Marco-Peter/Morgenmuffel/README.md

# Morgenmuffel
Ein nicht so muffiger Radiowecker
