Marco-Peter/Morgenmuffel/schema/Amplifier.kicad_sch

## KiCad design schema/Amplifier.kicad_sch (2022-03-19)

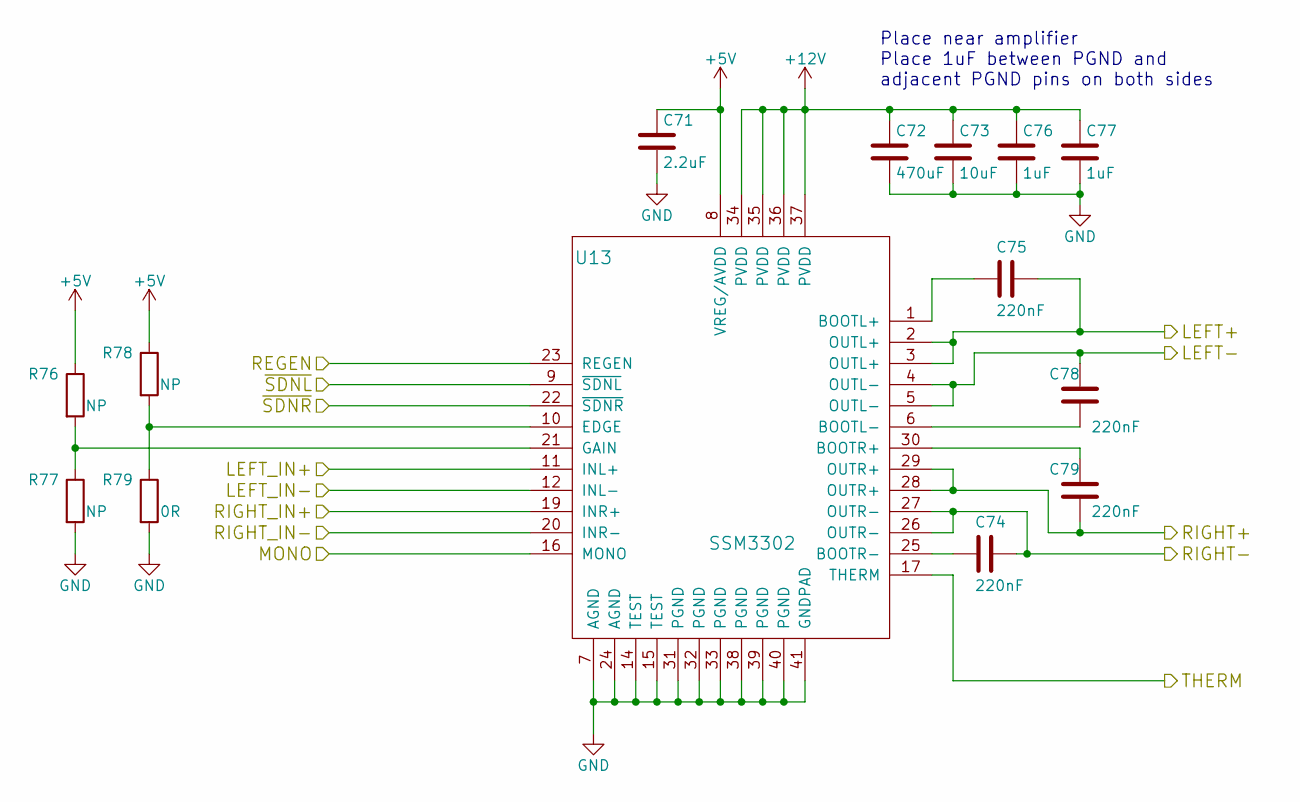
[picture p1: schematic Amplifier.kicad_sch]

Parts:
C71: 2.2uF; C_0603_HandSoldering
C72: 470uF; c_elec_10x10
C73: 10uF; C_1206_HandSoldering
C74, C75, C78, C79: 220nF; C_0603_HandSoldering
C76, C77: 1uF; C_0603_HandSoldering
R76, R77, R78: NP; R_0603_HandSoldering
R79: 0R; R_0603_HandSoldering
U13: SSM3302; QFN_40

Connections:
+5V: C71.1, R76.1, R78.1, U13.8 (VREG/AVDD)
+12V: C72.1, C73.1, C76.1, C77.1, U13.34 (PVDD), U13.35 (PVDD), U13.36 (PVDD), U13.37 (PVDD)
GND: C71.2, C72.2, C73.2, C76.2, C77.2, R77.2, R79.2, U13.7 (AGND), U13.14 (TEST), U13.15 (TEST), U13.24 (AGND), U13.31 (PGND), U13.32 (PGND), U13.33 (PGND), U13.38 (PGND), U13.39 (PGND), U13.40 (PGND), U13.41 (GNDPAD)
LEFT+: C75.1, U13.2 (OUTL+), U13.3 (OUTL+)
LEFT-: C78.1, U13.4 (OUTL-), U13.5 (OUTL-)
LEFT_IN+: U13.11 (INL+)
LEFT_IN-: U13.12 (INL-)
MONO: U13.16 (MONO)
unnamed: C74.2, U13.25 (BOOTR-)
unnamed: C75.2, U13.1 (BOOTL+)
unnamed: C78.2, U13.6 (BOOTL-)
unnamed: C79.1, U13.30 (BOOTR+)
unnamed: R76.2, R77.1, U13.21 (GAIN)
unnamed: R78.2, R79.1, U13.10 (EDGE)
REGEN: U13.23 (REGEN)
RIGHT+: C79.2, U13.28 (OUTR+), U13.29 (OUTR+)
RIGHT-: C74.1, U13.26 (OUTR-), U13.27 (OUTR-)
RIGHT_IN+: U13.19 (INR+)
RIGHT_IN-: U13.20 (INR-)
THERM: U13.17 (THERM)
~SDNL: U13.9 (~SDNL)
~SDNR: U13.22 (~SDNR)

Notes on the sheet:
Place near amplifier Place 1uF between PGND and adjacent PGND pins on both sides
