Marco-Peter/Morgenmuffel/schema/AudioOut.kicad_sch

## KiCad design schema/AudioOut.kicad_sch (2022-03-19)

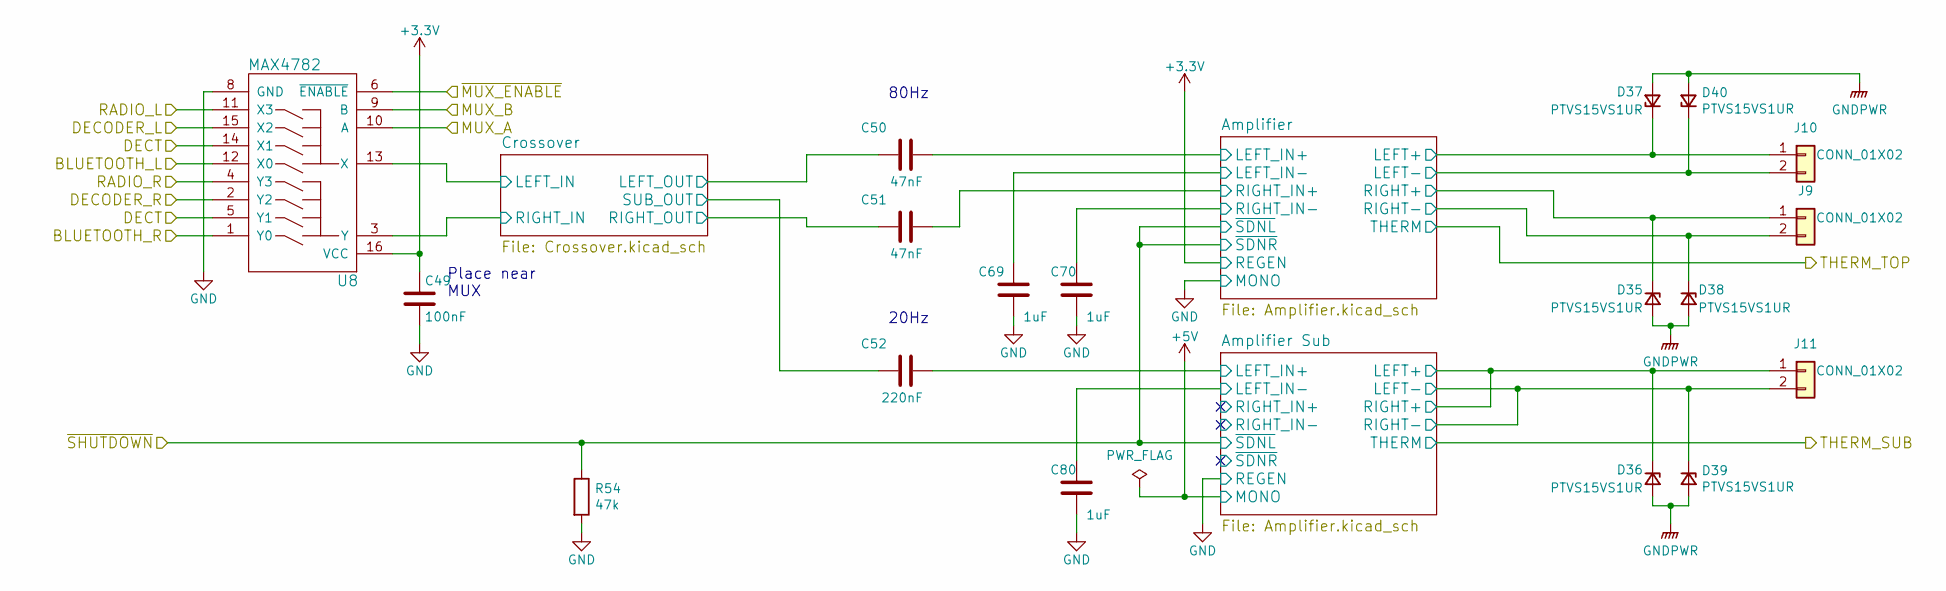
[picture p2: schematic AudioOut.kicad_sch]

Parts:
C49: 100nF; C_0603_HandSoldering
C50, C51: 47nF; C_0603_HandSoldering
C52: 220nF; C_0603_HandSoldering
C69, C70, C80: 1uF; C_0603_HandSoldering
D35, D36, D37, D38, D39, D40: PTVS15VS1UR; SOD-123
J9, J10, J11: CONN_01X02; PINHEAD1-2
R54: 47k; R_0603_HandSoldering
U8: MAX4782; TSSOP-16_4.4x5mm_Pitch0.65mm

Connections:
+3.3V: C49.1, U8.16 (VCC)
BLUETOOTH_L: U8.12 (X0)
BLUETOOTH_R: U8.1 (Y0)
DECODER_L: U8.15 (X2)
DECODER_R: U8.2 (Y2)
DECT: U8.5 (Y1), U8.14 (X1)
GND: C49.2, C69.2, C70.2, C80.2, R54.2, U8.8 (GND)
GNDPWR: D35.2 (A), D36.2 (A), D37.2 (A), D38.2 (A), D39.2 (A), D40.2 (A)
LEFT+: D36.1 (K), D37.1 (K), J10.1, J11.1
LEFT-: D39.1 (K), D40.1 (K), J10.2, J11.2
LEFT_IN: U8.13 (X)
LEFT_IN+: C50.2, C52.2
LEFT_IN-: C69.1, C80.1
LEFT_OUT: C50.1
MUX_A: U8.10 (A)
MUX_B: U8.9 (B)
RADIO_L: U8.11 (X3)
RADIO_R: U8.4 (Y3)
RIGHT+: D35.1 (K), J9.1
RIGHT-: D38.1 (K), J9.2
RIGHT_IN: U8.3 (Y)
RIGHT_IN+: C51.2
RIGHT_IN-: C70.1
RIGHT_OUT: C51.1
SUB_OUT: C52.1
~MUX_ENABLE: U8.6 (~ENABLE)
~SHUTDOWN: R54.1

Notes on the sheet:
80Hz
Place near MUX
20Hz
