Marco-Peter/Morgenmuffel/schema/BlueTooth.kicad_sch

## KiCad design schema/BlueTooth.kicad_sch (2022-03-19)

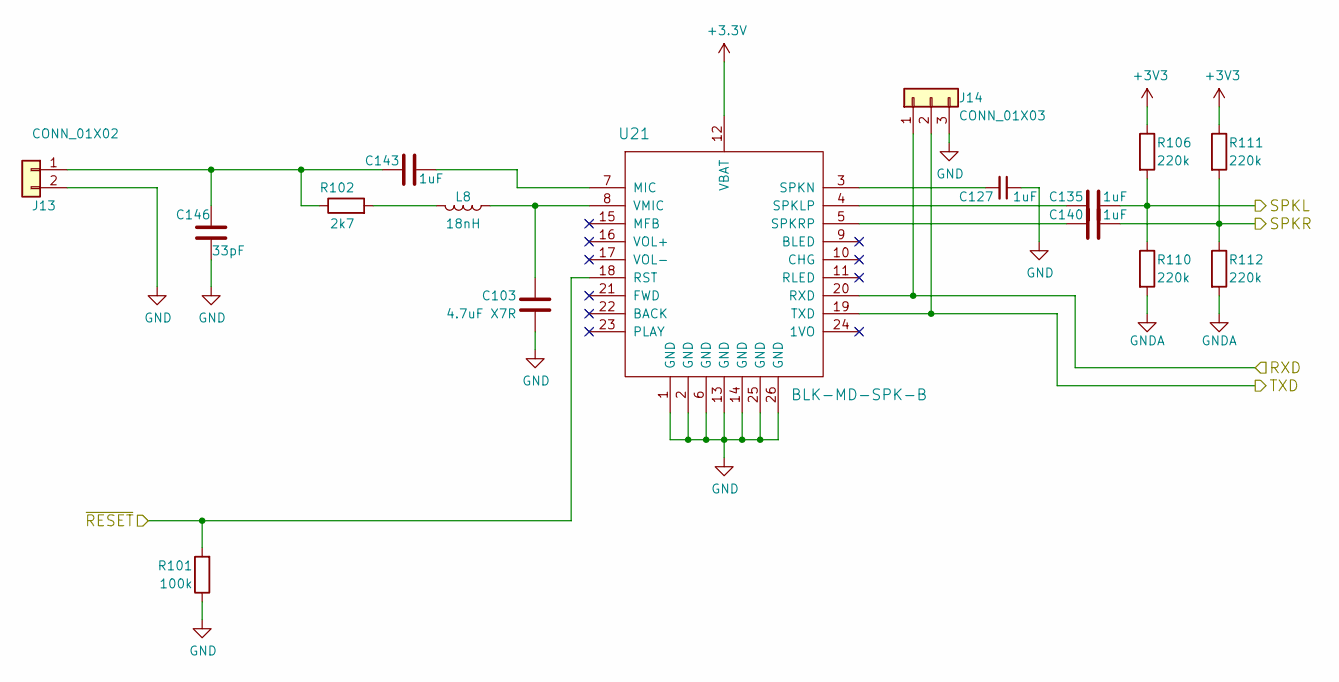
[picture p3: schematic BlueTooth.kicad_sch]

Parts:
C103: 4.7uF X7R; C_1206_HandSoldering
C127, C135, C140, C143: 1uF; C_0603_HandSoldering
C146: 33pF; C_0603_HandSoldering
J13: CONN_01X02; Pin_Header_Straight_1x02
J14: CONN_01X03; Pin_Header_Straight_1x03
L8: 18nH; R_0603_HandSoldering
R101: 100k; R_0603_HandSoldering
R102: 2k7; R_0603_HandSoldering
R106, R110, R111, R112: 220k; R_0603_HandSoldering
U21: BLK-MD-SPK-B

Connections:
+3.3V: U21.12 (VBAT)
+3V3: R106.1, R111.1
GND: C103.2, C127.1, C146.2, J13.2, J14.3, R101.1, U21.1 (GND), U21.2 (GND), U21.6 (GND), U21.13 (GND), U21.14 (GND), U21.25 (GND), U21.26 (GND)
GNDA: R110.2, R112.2
unnamed: C103.1, L8.1, U21.8 (VMIC)
unnamed: C127.2, U21.3 (SPKN)
unnamed: C135.2, U21.4 (SPKLP)
unnamed: C140.2, U21.5 (SPKRP)
unnamed: C143.1, U21.7 (MIC)
unnamed: C143.2, C146.1, J13.1, R102.1
unnamed: L8.2, R102.2
RXD: J14.1, U21.20 (RXD)
SPKL: C135.1, R106.2, R110.1
SPKR: C140.1, R111.2, R112.1
TXD: J14.2, U21.19 (TXD)
~RESET: R101.2, U21.18 (RST)
