Marco-Peter/Morgenmuffel/schema/Button.kicad_sch

## KiCad design schema/Button.kicad_sch (2022-03-19)

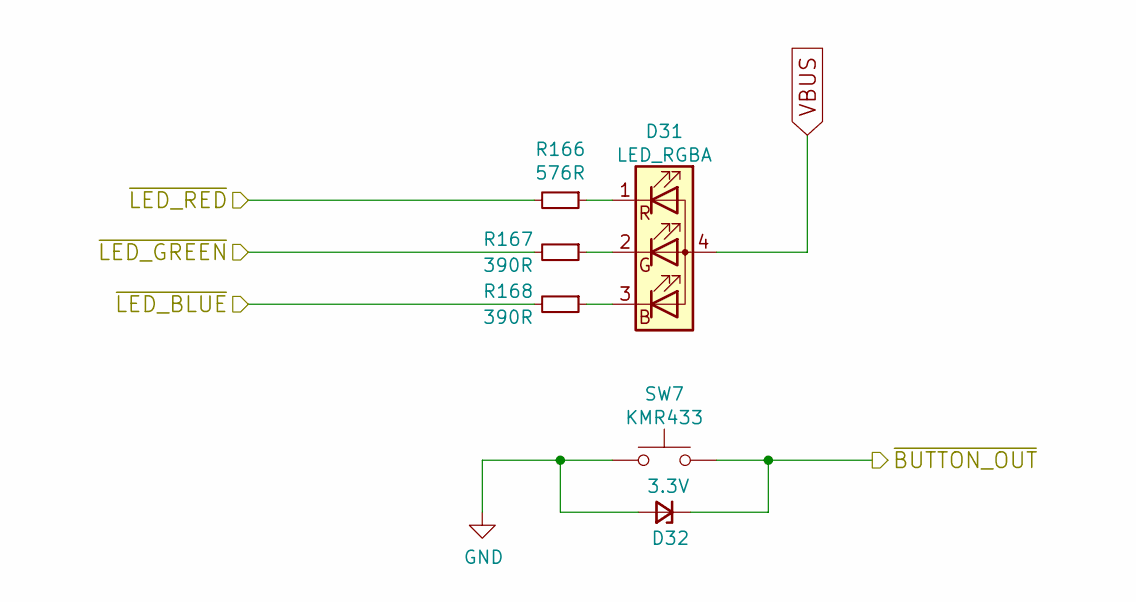
[picture p4: schematic Button.kicad_sch]

Parts:
D31: LED_RGBA; LED-PLCC4
D32: 3.3V; SOD-523
R166: 576R; R_0603_HandSoldering
R167, R168: 390R; R_0603_HandSoldering
SW7: KMR433; SW_SPST_KMR2

Connections:
GND: D32.2 (A), SW7.1
unnamed: D31.1 (RK), R166.1
unnamed: D31.2 (GK), R167.1
unnamed: D31.3 (BK), R168.1
VBUS: D31.4 (A)
~BUTTON_OUT: D32.1 (K), SW7.2
~LED_BLUE: R168.2
~LED_GREEN: R167.2
~LED_RED: R166.2
