Marco-Peter/Morgenmuffel/schema/CPU.kicad_sch

## KiCad design schema/CPU.kicad_sch (2022-03-19)

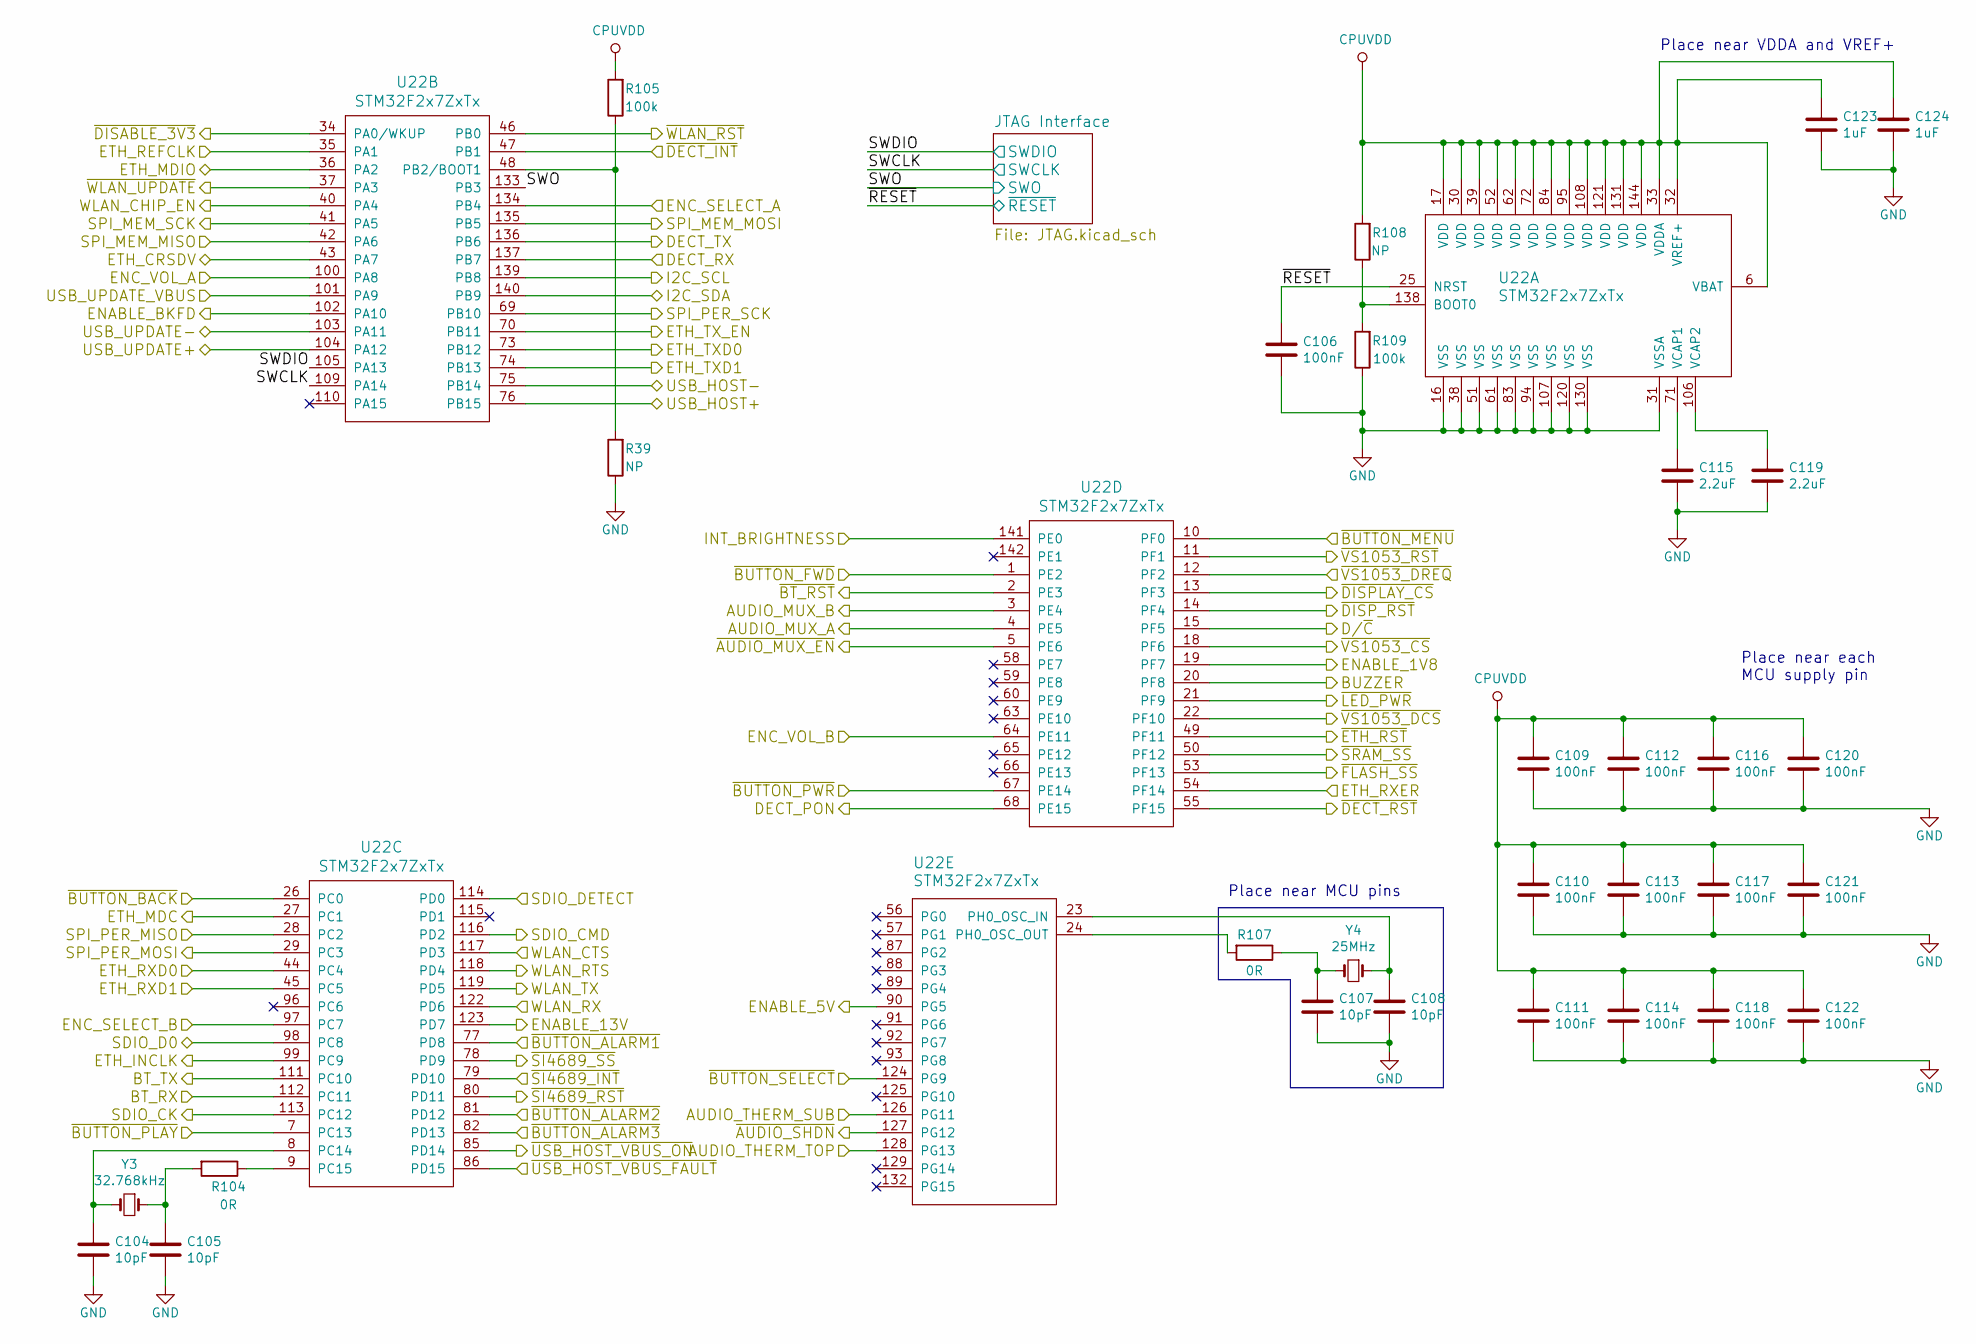
[picture p5: schematic CPU.kicad_sch]

Parts:
C104, C105, C107, C108: 10pF; C_0603_HandSoldering
C106, C109, C110, C111, C112, C113, C114, C116, C117, C118, C120, C121, C122: 100nF; C_0603_HandSoldering
C115, C119: 2.2uF; C_0603_HandSoldering
C123, C124: 1uF; C_0603_HandSoldering
R39, R108: NP; R_0603_HandSoldering
R104, R107: 0R; R_0603_HandSoldering
R105, R109: 100k; R_0603_HandSoldering
U22: STM32F2x7ZxTx; LQFP-144_20x20mm_Pitch0.5mm
Y3: 32.768kHz; R_0805_HandSoldering
Y4: 25MHz; Crystal_SMD_5032_4Pads

Connections:
AUDIO_MUX_A: U22.4 (PE5)
AUDIO_MUX_B: U22.3 (PE4)
AUDIO_THERM_SUB: U22.126 (PG11)
AUDIO_THERM_TOP: U22.128 (PG13)
BT_RX: U22.112 (PC11)
BT_TX: U22.111 (PC10)
BUZZER: U22.20 (PF8)
CPUVDD: C109.1, C110.1, C111.1, C112.1, C113.1, C114.1, C116.1, C117.1, C118.1, C120.1, C121.1, C122.1, C123.1, C124.1, R105.2, R108.2, U22.6 (VBAT), U22.17 (VDD), U22.30 (VDD), U22.32 (VREF+), U22.33 (VDDA), U22.39 (VDD), U22.52 (VDD), U22.62 (VDD), U22.72 (VDD), U22.84 (VDD), U22.95 (VDD), U22.108 (VDD), U22.121 (VDD), U22.131 (VDD), U22.144 (VDD)
D/~C: U22.15 (PF5)
DECT_PON: U22.68 (PE15)
DECT_RX: U22.137 (PB7)
DECT_TX: U22.136 (PB6)
ENABLE_1V8: U22.19 (PF7)
ENABLE_5V: U22.90 (PG5)
ENABLE_13V: U22.123 (PD7)
ENABLE_BKFD: U22.102 (PA10)
ENC_SELECT_A: U22.134 (PB4)
ENC_SELECT_B: U22.97 (PC7)
ENC_VOL_A: U22.100 (PA8)
ENC_VOL_B: U22.64 (PE11)
ETH_CRSDV: U22.43 (PA7)
ETH_INCLK: U22.99 (PC9)
ETH_MDC: U22.27 (PC1)
ETH_MDIO: U22.36 (PA2)
ETH_REFCLK: U22.35 (PA1)
ETH_RXD0: U22.44 (PC4)
ETH_RXD1: U22.45 (PC5)
ETH_RXER: U22.54 (PF14)
ETH_TXD0: U22.73 (PB12)
ETH_TXD1: U22.74 (PB13)
ETH_TX_EN: U22.70 (PB11)
GND: C104.2, C105.2, C106.2, C107.2, C108.2, C109.2, C110.2, C111.2, C112.2, C113.2, C114.2, C115.2, C116.2, C117.2, C118.2, C119.2, C120.2, C121.2, C122.2, C123.2, C124.2, R39.1, R109.1, U22.16 (VSS), U22.31 (VSSA), U22.38 (VSS), U22.51 (VSS), U22.61 (VSS), U22.83 (VSS), U22.94 (VSS), U22.107 (VSS), U22.120 (VSS), U22.130 (VSS)
I2C_SCL: U22.139 (PB8)
I2C_SDA: U22.140 (PB9)
INT_BRIGHTNESS: U22.141 (PE0)
unnamed: C104.1, U22.8 (PC14), Y3.2
unnamed: C105.1, R104.2, Y3.1
unnamed: C107.1, R107.1, Y4.2
unnamed: C108.1, U22.23 (PH0_OSC_IN), Y4.1
unnamed: C115.1, U22.71 (VCAP1)
unnamed: C119.1, U22.106 (VCAP2)
unnamed: R104.1, U22.9 (PC15)
unnamed: R39.2, R105.1, U22.48 (PB2/BOOT1)
unnamed: R107.2, U22.24 (PH0_OSC_OUT)
unnamed: R108.1, R109.2, U22.138 (BOOT0)
SDIO_CK: U22.113 (PC12)
SDIO_CMD: U22.116 (PD2)
SDIO_D0: U22.98 (PC8)
SDIO_DETECT: U22.114 (PD0)
SPI_MEM_MISO: U22.42 (PA6)
SPI_MEM_MOSI: U22.135 (PB5)
SPI_MEM_SCK: U22.41 (PA5)
SPI_PER_MISO: U22.28 (PC2)
SPI_PER_MOSI: U22.29 (PC3)
SPI_PER_SCK: U22.69 (PB10)
SWCLK: U22.109 (PA14)
SWDIO: U22.105 (PA13)
SWO: U22.133 (PB3)
USB_HOST+: U22.76 (PB15)
USB_HOST-: U22.75 (PB14)
USB_UPDATE+: U22.104 (PA12)
USB_UPDATE-: U22.103 (PA11)
USB_UPDATE_VBUS: U22.101 (PA9)
WLAN_CHIP_EN: U22.40 (PA4)
WLAN_CTS: U22.117 (PD3)
WLAN_RTS: U22.118 (PD4)
WLAN_RX: U22.122 (PD6)
WLAN_TX: U22.119 (PD5)
~AUDIO_MUX_EN: U22.5 (PE6)
~AUDIO_SHDN: U22.127 (PG12)
~BT_RST: U22.2 (PE3)
~BUTTON_ALARM1: U22.77 (PD8)
~BUTTON_ALARM2: U22.81 (PD12)
~BUTTON_ALARM3: U22.82 (PD13)
~BUTTON_BACK: U22.26 (PC0)
~BUTTON_FWD: U22.1 (PE2)
~BUTTON_MENU: U22.10 (PF0)
~BUTTON_PLAY: U22.7 (PC13)
~BUTTON_PWR: U22.67 (PE14)
~BUTTON_SELECT: U22.124 (PG9)
~DECT_INT: U22.47 (PB1)
~DECT_RST: U22.55 (PF15)
~DISABLE_3V3: U22.34 (PA0/WKUP)
~DISPLAY_CS: U22.13 (PF3)
~DISP_RST: U22.14 (PF4)
~ETH_RST: U22.49 (PF11)
~FLASH_SS: U22.53 (PF13)
~LED_PWR: U22.21 (PF9)
~RESET: C106.1, U22.25 (NRST)
~SI4689_INT: U22.79 (PD10)
~SI4689_RST: U22.80 (PD11)
~SI4689_SS: U22.78 (PD9)
~SRAM_SS: U22.50 (PF12)
~USB_HOST_VBUS_FAULT: U22.86 (PD15)
~USB_HOST_VBUS_ON: U22.85 (PD14)
~VS1053_CS: U22.18 (PF6)
~VS1053_DCS: U22.22 (PF10)
~VS1053_DREQ: U22.12 (PF2)
~VS1053_RST: U22.11 (PF1)
~WLAN_RST: U22.46 (PB0)
~WLAN_UPDATE: U22.37 (PA3)

Notes on the sheet:
Place near MCU pins
Place near VDDA and VREF+
Place near each MCU supply pin
