Marco-Peter/Morgenmuffel/schema/Crossover.kicad_sch

## KiCad design schema/Crossover.kicad_sch (2022-03-19)

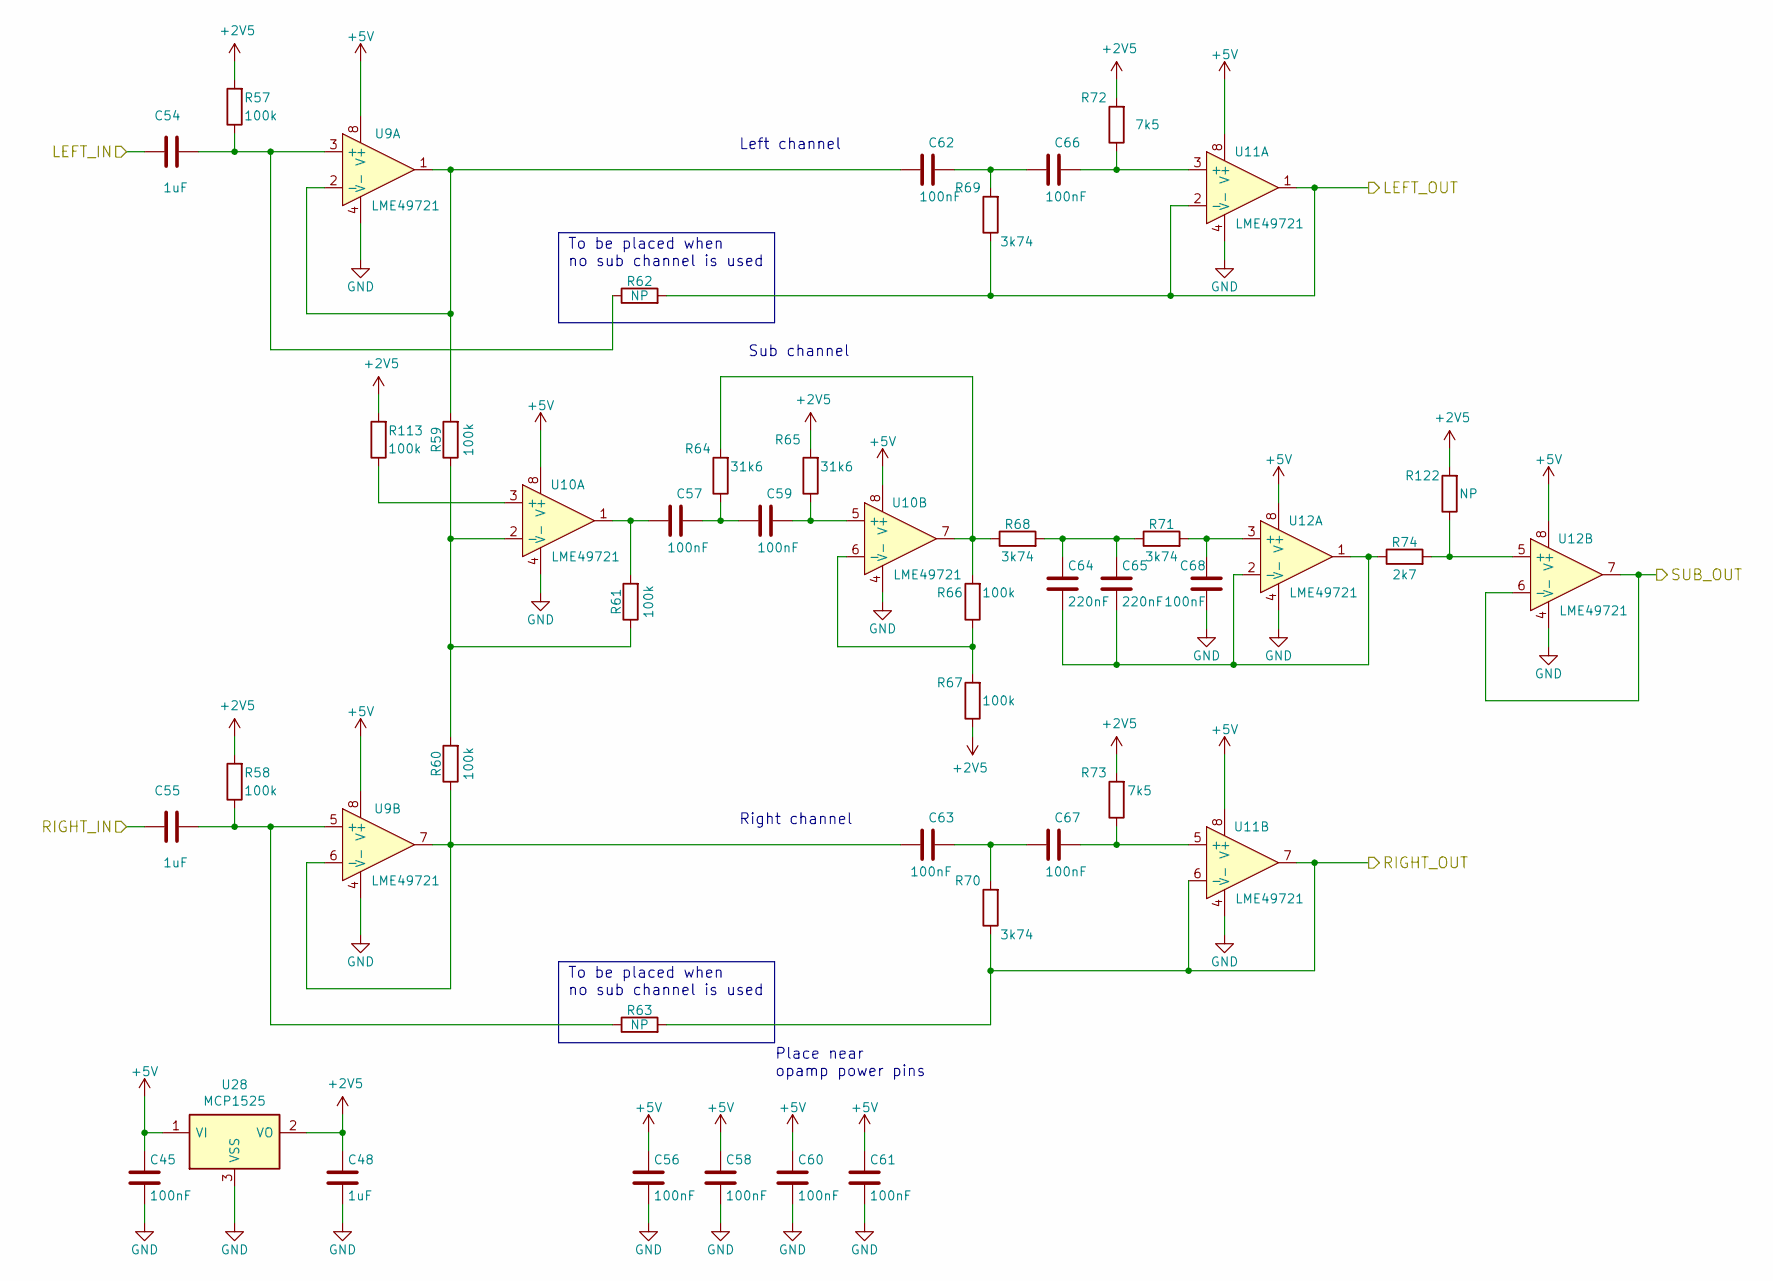
[picture p6: schematic Crossover.kicad_sch]

Parts:
C45, C56, C57, C58, C59, C60, C61, C62, C63, C66, C67, C68: 100nF; C_0603_HandSoldering
C48, C54, C55: 1uF; C_0603_HandSoldering
C64, C65: 220nF; C_0603_HandSoldering
R57, R58, R59, R60, R61, R66, R67, R113: 100k; R_0603_HandSoldering
R62, R63, R122: NP; R_0603_HandSoldering
R64, R65: 31k6; R_0603_HandSoldering
R68, R69, R70, R71: 3k74; R_0603_HandSoldering
R72, R73: 7k5; R_0603_HandSoldering
R74: 2k7; R_0603_HandSoldering
U9, U10, U11, U12: LME49721; SOIC-8_3.9x4.9mm_Pitch1.27mm
U28: MCP1525; SOT-23_Handsoldering

Connections:
+2V5: C48.1, R57.2, R58.2, R65.2, R67.1, R72.2, R73.2, R113.2, R122.2, U28.2 (VO)
+5V: C45.1, C56.1, C58.1, C60.1, C61.1, U9.8 (V+), U10.8 (V+), U11.8 (V+), U12.8 (V+), U28.1 (VI)
GND: C45.2, C48.2, C56.2, C58.2, C60.2, C61.2, C68.2, U9.4 (V-), U10.4 (V-), U11.4 (V-), U12.4 (V-), U28.3 (VSS)
LEFT_IN: C54.2
LEFT_OUT: R62.2, R69.1, U11.1, U11.2 (-)
unnamed: C54.1, R57.1, R62.1, U9.3 (+)
unnamed: C55.1, R58.1, R63.1, U9.5 (+)
unnamed: C57.1, C59.2, R64.1
unnamed: C57.2, R61.2, U10.1
unnamed: C59.1, R65.1, U10.5 (+)
unnamed: C62.1, C66.2, R69.2
unnamed: C62.2, R59.2, U9.1, U9.2 (-)
unnamed: C63.1, C67.2, R70.2
unnamed: C63.2, R60.1, U9.6 (-), U9.7
unnamed: C64.1, C65.1, R68.2, R71.1
unnamed: C64.2, C65.2, R74.1, U12.1, U12.2 (-)
unnamed: C66.1, R72.1, U11.3 (+)
unnamed: C67.1, R73.1, U11.5 (+)
unnamed: C68.1, R71.2, U12.3 (+)
unnamed: R59.1, R60.2, R61.1, U10.2 (-)
unnamed: R64.2, R66.2, R68.1, U10.7
unnamed: R66.1, R67.2, U10.6 (-)
unnamed: R113.1, U10.3 (+)
unnamed: R74.2, R122.1, U12.5 (+)
RIGHT_IN: C55.2
RIGHT_OUT: R63.2, R70.1, U11.6 (-), U11.7
SUB_OUT: U12.6 (-), U12.7

Notes on the sheet:
Place near opamp power pins
To be placed when no sub channel is used
Sub channel
Right channel
Left channel
