Marco-Peter/Morgenmuffel/schema/DECT.kicad_sch

## KiCad design schema/DECT.kicad_sch (2022-03-19)

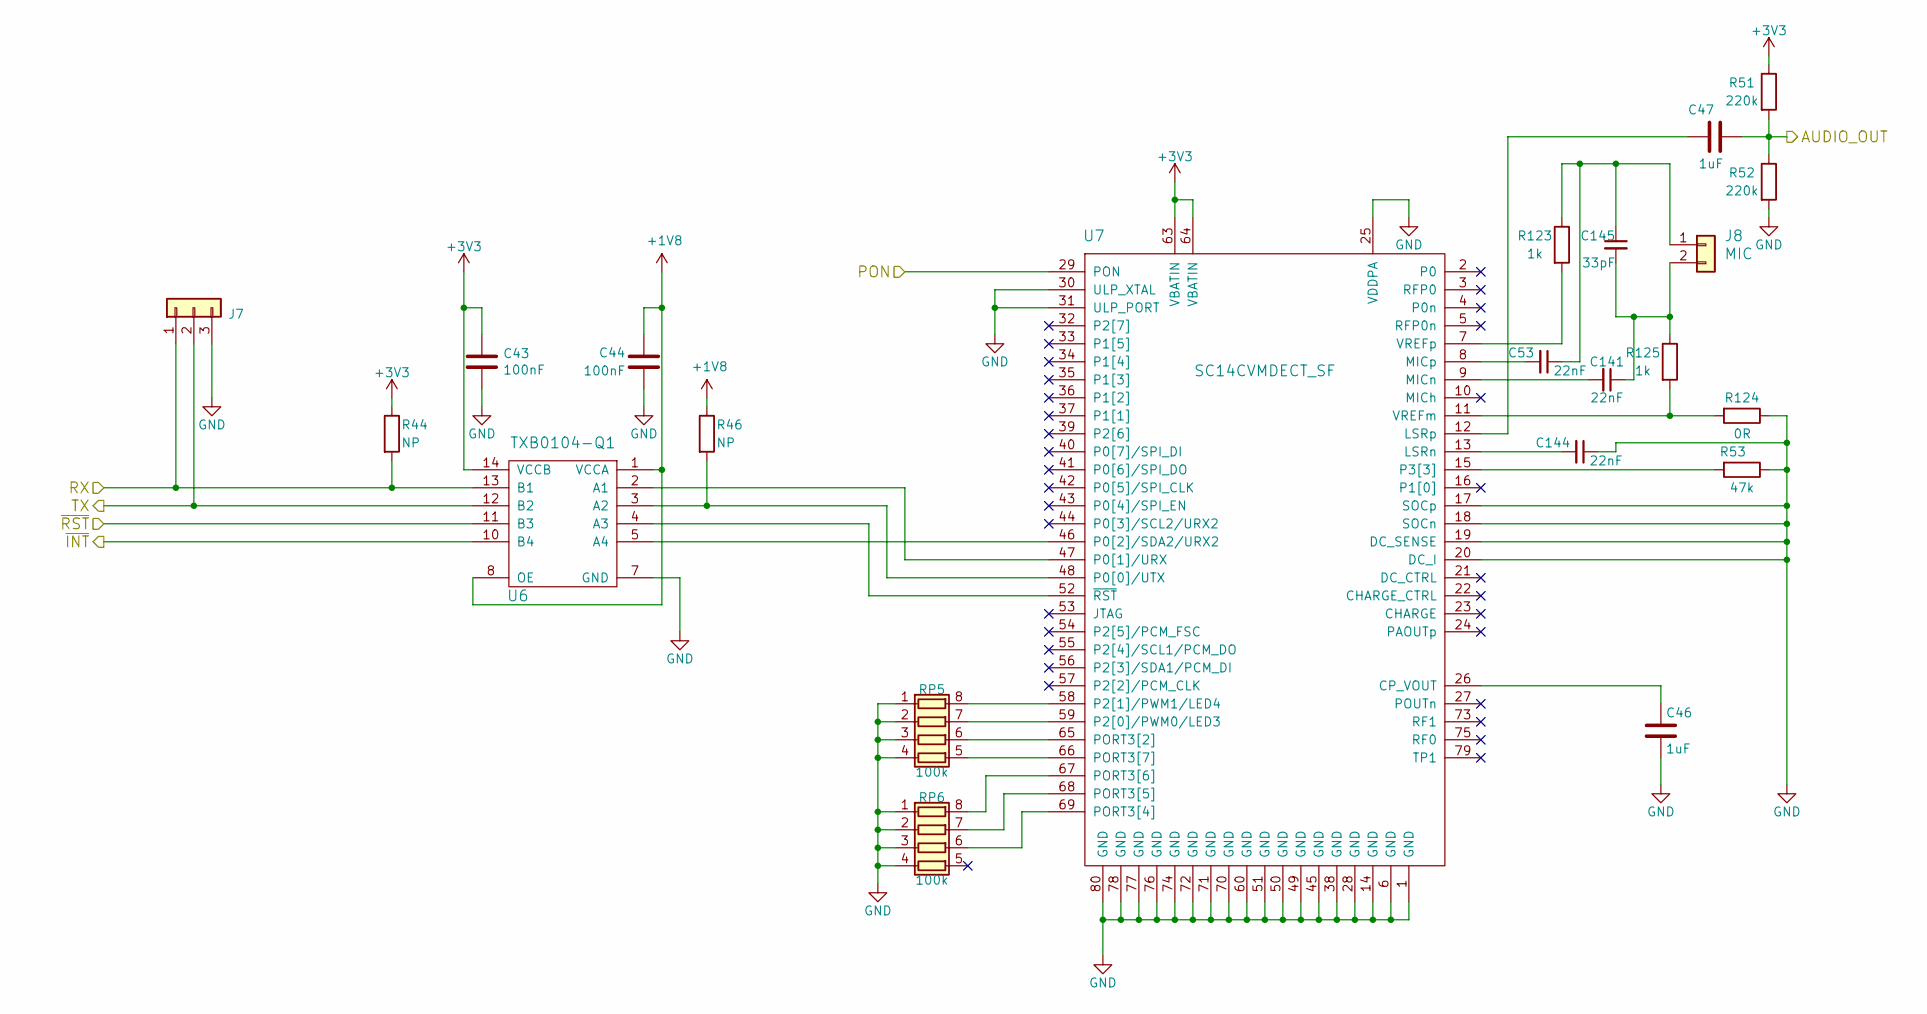
[picture p7: schematic DECT.kicad_sch]

Parts:
C43, C44: 100nF; C_0603_HandSoldering
C46, C47: 1uF; C_0603_HandSoldering
C53, C141, C144: 22nF; C_0603_HandSoldering
C145: 33pF; C_0603_HandSoldering
J7: CONN_01X03; Pin_Header_Straight_1x03
J8: MIC; Pin_Header_Straight_1x02
R44, R46: NP; R_0603_HandSoldering
R51, R52: 220k; R_0603_HandSoldering
R53: 47k; R_0603_HandSoldering
R123, R125: 1k; R_0603_HandSoldering
R124: 0R; R_0603_HandSoldering
RP5, RP6: 100k; R_Array_Convex_4x0603
U6: TXB0104-Q1; TSSOP-14_4.4x5mm_Pitch0.65mm
U7: SC14CVMDECT_SF

Connections:
+1V8: C44.1, R46.1, U6.1 (VCCA), U6.8 (OE)
+3V3: C43.1, R44.1, R51.1, U6.14 (VCCB), U7.63 (VBATIN), U7.64 (VBATIN)
AUDIO_OUT: C47.2, R51.2, R52.1
GND: C43.2, C44.2, C46.2, C144.1, J7.3, R52.2, R53.1, R124.1, RP5.1 (R1.1), RP5.2 (R2.1), RP5.3 (R3.1), RP5.4 (R4.1), RP6.1 (R1.1), RP6.2 (R2.1), RP6.3 (R3.1), RP6.4 (R4.1), U6.7 (GND), U7.1 (GND), U7.6 (GND), U7.14 (GND), U7.17 (SOCp), U7.18 (SOCn), U7.19 (DC_SENSE), U7.20 (DC_I), U7.25 (VDDPA), U7.28 (GND), U7.30 (ULP_XTAL), U7.31 (ULP_PORT), U7.38 (GND), U7.45 (GND), U7.49 (GND), U7.50 (GND), U7.51 (GND), U7.60 (GND), U7.70 (GND), U7.71 (GND), U7.72 (GND), U7.74 (GND), U7.76 (GND), U7.77 (GND), U7.78 (GND), U7.80 (GND)
unnamed: C46.1, U7.26 (CP_VOUT)
unnamed: C47.1, U7.12 (LSRp)
unnamed: C53.2, U7.8 (MICp)
unnamed: C141.1, C145.2, J8.2, R125.1
unnamed: C141.2, U7.9 (MICn)
unnamed: C144.2, U7.13 (LSRn)
unnamed: C53.1, C145.1, J8.1, R123.1
unnamed: R46.2, U6.3 (A2), U7.48 (P0[0]/UTX)
unnamed: R53.2, U7.15 (P3[3])
unnamed: R123.2, U7.7 (VREFp)
unnamed: R124.2, R125.2, U7.11 (VREFm)
unnamed: RP5.5 (R4.2), U7.66 (PORT3[7])
unnamed: RP5.6 (R3.2), U7.65 (PORT3[2])
unnamed: RP5.7 (R2.2), U7.59 (P2[0]/PWM0/LED3)
unnamed: RP5.8 (R1.2), U7.58 (P2[1]/PWM1/LED4)
unnamed: RP6.6 (R3.2), U7.69 (PORT3[4])
unnamed: RP6.7 (R2.2), U7.68 (PORT3[5])
unnamed: RP6.8 (R1.2), U7.67 (PORT3[6])
unnamed: U6.2 (A1), U7.47 (P0[1]/URX)
unnamed: U6.4 (A3), U7.52 (~RST)
unnamed: U6.5 (A4), U7.46 (P0[2]/SDA2/URX2)
PON: U7.29 (PON)
RX: J7.1, R44.2, U6.13 (B1)
TX: J7.2, U6.12 (B2)
~INT: U6.10 (B4)
~RST: U6.11 (B3)
