Marco-Peter/Morgenmuffel/schema/Display.kicad_sch

## KiCad design schema/Display.kicad_sch (2022-03-19)

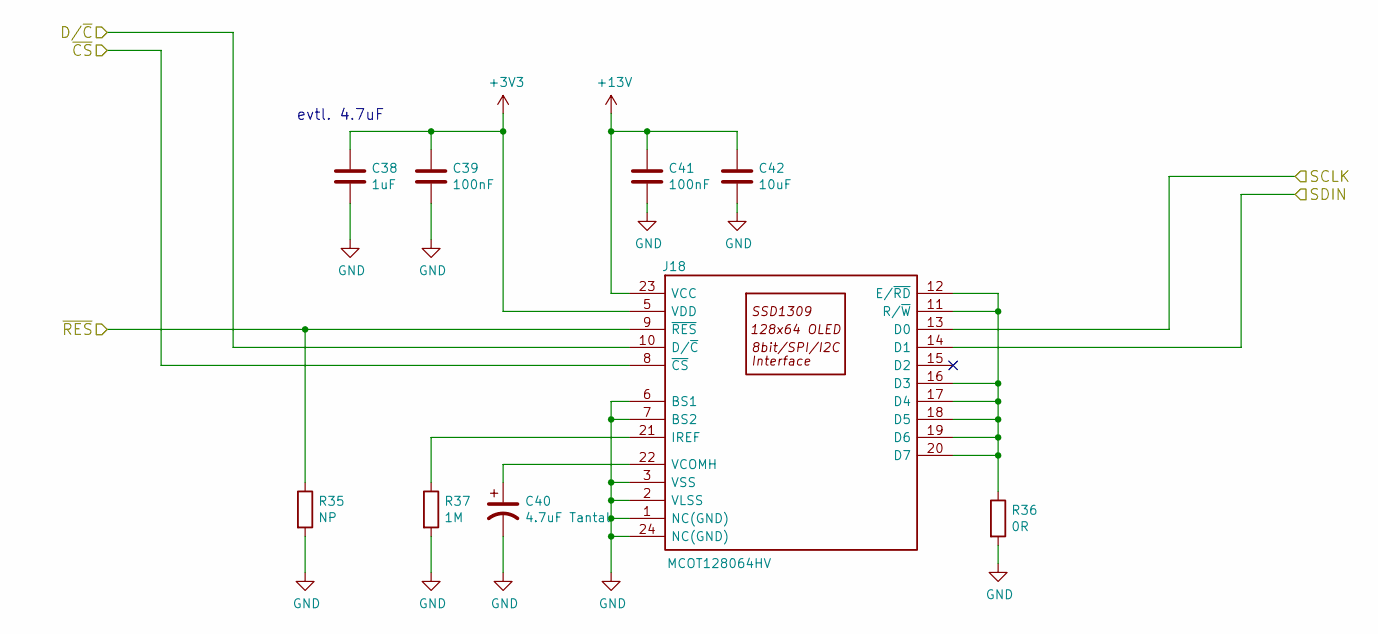
[picture p8: schematic Display.kicad_sch]

Parts:
C38: 1uF; C_0603_HandSoldering
C39, C41: 100nF; C_0603_HandSoldering
C40: 4.7uF Tantal; C_1206
C42: 10uF; C_1206_HandSoldering
J18: MCOT128064HV; FPC_24
R35: NP; R_0603_HandSoldering
R36: 0R; R_0603_HandSoldering
R37: 1M; R_0603_HandSoldering

Connections:
+3V3: C38.1, C39.1, J18.5 (VDD)
+13V: C41.1, C42.1, J18.23 (VCC)
D/~C: J18.10 (D/~C)
GND: C38.2, C39.2, C40.2, C41.2, C42.2, J18.1 (NC(GND)), J18.2 (VLSS), J18.3 (VSS), J18.6 (BS1), J18.7 (BS2), J18.24 (NC(GND)), R35.2, R36.2, R37.2
unnamed: C40.1, J18.22 (VCOMH)
unnamed: J18.11 (R/~W), J18.12 (E/~RD), J18.16 (D3), J18.17 (D4), J18.18 (D5), J18.19 (D6), J18.20 (D7), R36.1
unnamed: J18.21 (IREF), R37.1
SCLK: J18.13 (D0)
SDIN: J18.14 (D1)
~CS: J18.8 (~CS)
~RES: J18.9 (~RES), R35.1

Notes on the sheet:
evtl. 4.7uF
