Marco-Peter/Morgenmuffel/schema/Encoder.kicad_sch

## KiCad design schema/Encoder.kicad_sch (2022-03-19)

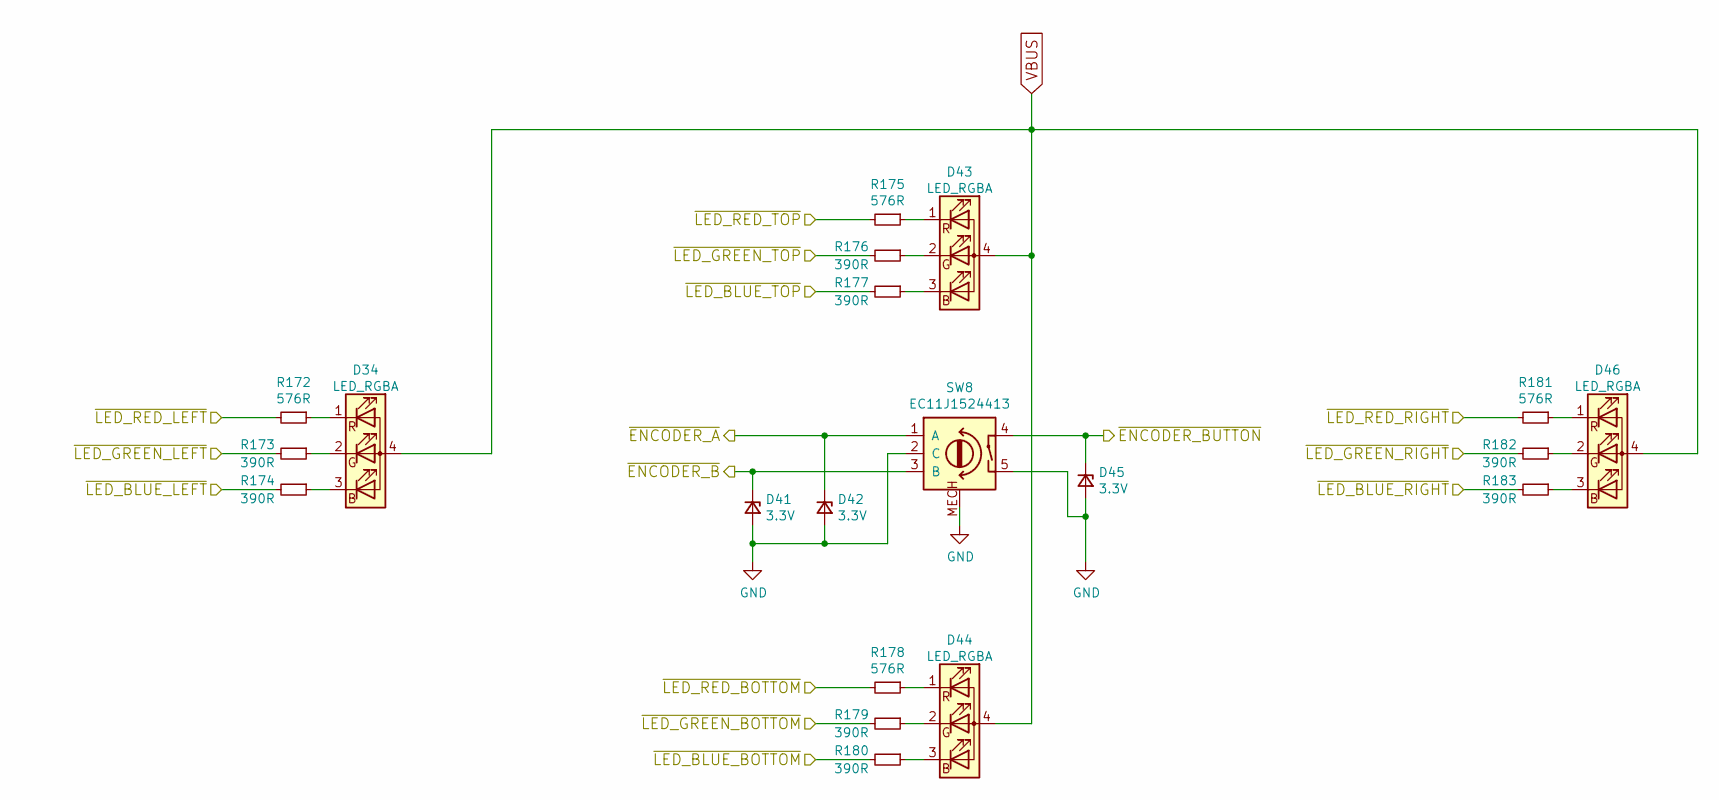
[picture p9: schematic Encoder.kicad_sch]

Parts:
D34, D43, D44, D46: LED_RGBA; LED-PLCC4
D41, D42, D45: 3.3V; SOD-523
R172, R175, R178, R181: 576R; R_0603_HandSoldering
R173, R174, R176, R177, R179, R180, R182, R183: 390R; R_0603_HandSoldering
SW8: EC11J1524413; Encoder_Alps_EC11J

Connections:
GND: D41.2 (A), D42.2 (A), D45.2 (A), SW8.2 (C), SW8.5, SW8.MECH
unnamed: D34.1 (RK), R172.1
unnamed: D34.2 (GK), R173.1
unnamed: D34.3 (BK), R174.1
unnamed: D43.1 (RK), R175.1
unnamed: D43.2 (GK), R176.1
unnamed: D43.3 (BK), R177.1
unnamed: D44.1 (RK), R178.1
unnamed: D44.2 (GK), R179.1
unnamed: D44.3 (BK), R180.1
unnamed: D46.1 (RK), R181.1
unnamed: D46.2 (GK), R182.1
unnamed: D46.3 (BK), R183.1
VBUS: D34.4 (A), D43.4 (A), D44.4 (A), D46.4 (A)
~ENCODER_A: D42.1 (K), SW8.1 (A)
~ENCODER_BUTTON: D45.1 (K), SW8.4
~ENCODER_B: D41.1 (K), SW8.3 (B)
~LED_BLUE_BOTTOM: R180.2
~LED_BLUE_LEFT: R174.2
~LED_BLUE_RIGHT: R183.2
~LED_BLUE_TOP: R177.2
~LED_GREEN_BOTTOM: R179.2
~LED_GREEN_LEFT: R173.2
~LED_GREEN_RIGHT: R182.2
~LED_GREEN_TOP: R176.2
~LED_RED_BOTTOM: R178.2
~LED_RED_LEFT: R172.2
~LED_RED_RIGHT: R181.2
~LED_RED_TOP: R175.2
