Marco-Peter/Morgenmuffel/schema/Ethernet.kicad_sch

## KiCad design schema/Ethernet.kicad_sch (2022-03-19)

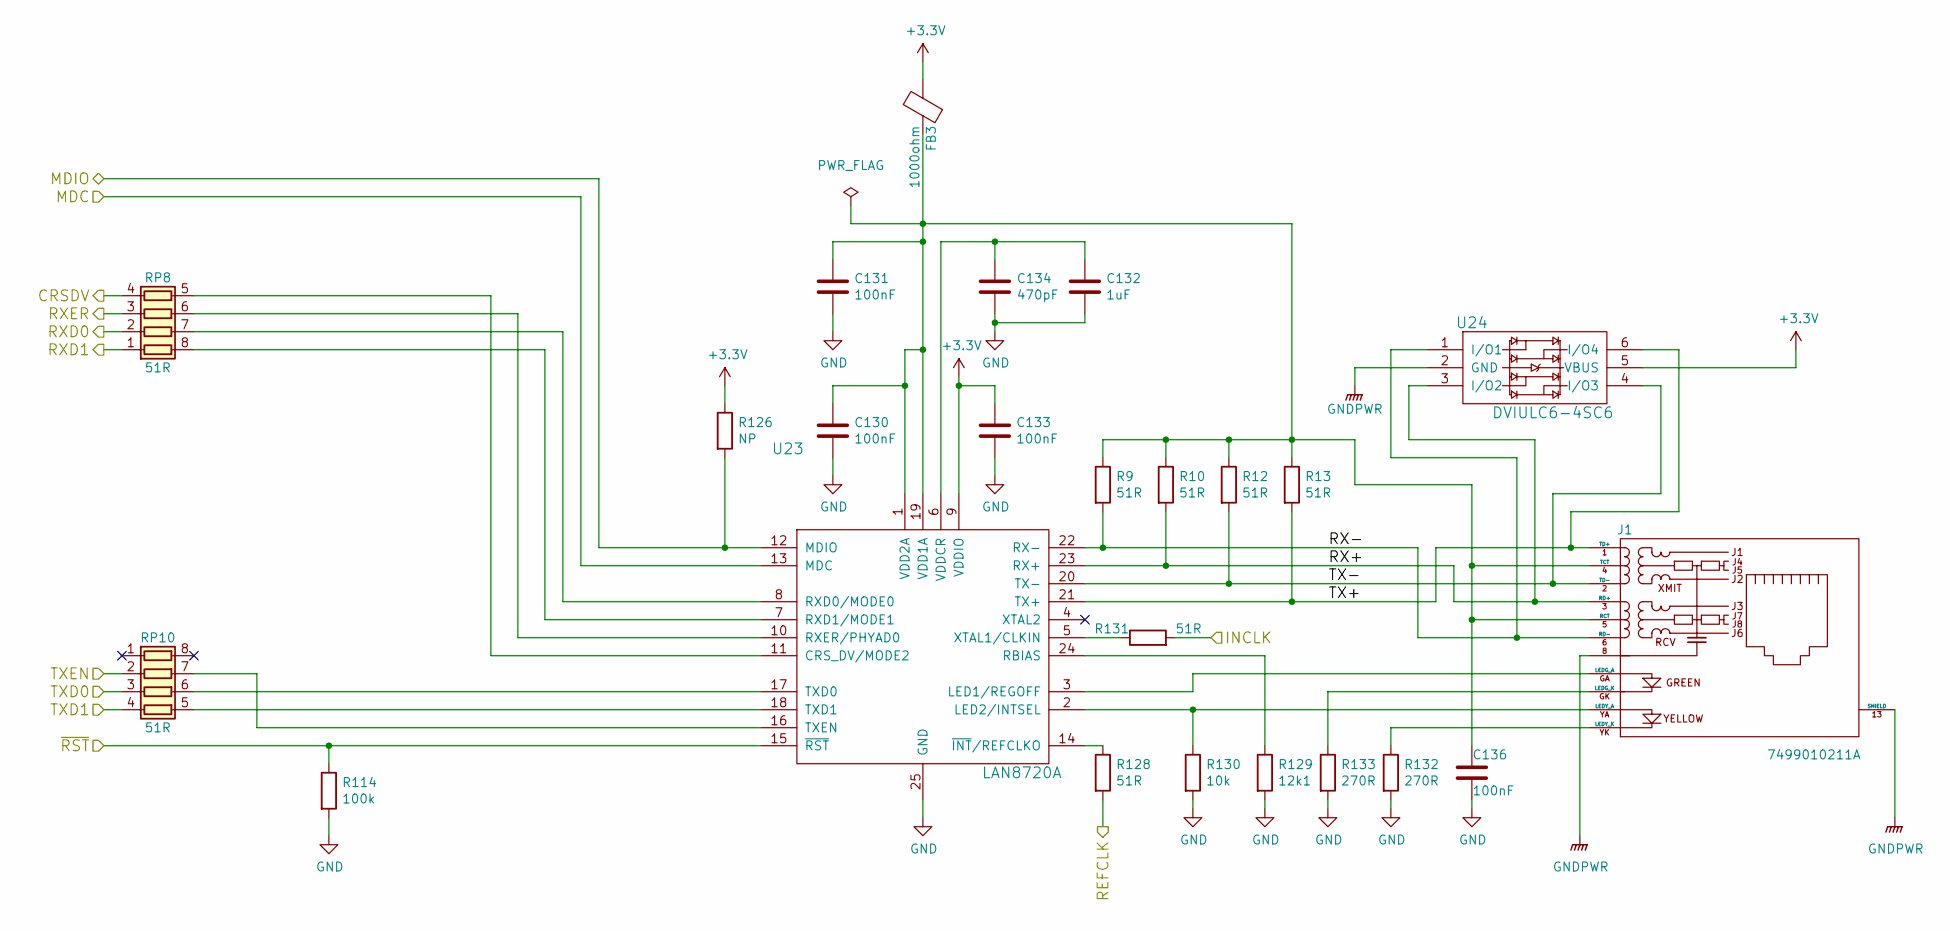
[picture p10: schematic Ethernet.kicad_sch]

Parts:
C130, C131, C133, C136: 100nF; C_0603_HandSoldering
C132: 1uF; C_0603_HandSoldering
C134: 470pF; C_0603_HandSoldering
FB3: 1000ohm; R_0603_HandSoldering
J1: 7499010211A
R9, R10, R12, R13, R128, R131: 51R; R_0603_HandSoldering
R114: 100k; R_0603_HandSoldering
R126: NP; R_0603_HandSoldering
R129: 12k1; R_0603_HandSoldering
R130: 10k; R_0603_HandSoldering
R132, R133: 270R; R_0603_HandSoldering
RP8, RP10: 51R; R_Array_Concave_4x0402
U23: LAN8720A; QFN_24
U24: DVIULC6-4SC6; SOT-23-6_Handsoldering; Part Number DVIULC6-4SC6

Connections:
+3.3V: C133.1, FB3.2, R126.1, U23.9 (VDDIO), U24.5 (VBUS)
CRSDV: RP8.4 (R4.1)
GND: C130.2, C131.2, C132.2, C133.2, C134.2, C136.2, R114.2, R129.2, R130.2, R132.2, R133.2, U23.25 (GND)
GNDPWR: J1.8, J1.13 (SHIELD), U24.2 (GND)
INCLK: R131.2
MDC: U23.13 (MDC)
MDIO: R126.2, U23.12 (MDIO)
unnamed: C130.1, C131.1, C136.1, FB3.1, J1.4 (TCT), J1.5 (RCT), R9.1, R10.1, R12.1, R13.1, U23.1 (VDD2A), U23.19 (VDD1A)
unnamed: C132.1, C134.1, U23.6 (VDDCR)
unnamed: J1.GA (LEDG_A), U23.3 (LED1/REGOFF)
unnamed: J1.GK (LEDG_K), R133.1
unnamed: J1.YA (LEDY_A), R130.1, U23.2 (LED2/INTSEL)
unnamed: J1.YK (LEDY_K), R132.1
unnamed: R128.1, U23.14 (~INT/REFCLKO)
unnamed: R129.1, U23.24 (RBIAS)
unnamed: R131.1, U23.5 (XTAL1/CLKIN)
unnamed: RP8.5 (R4.2), U23.11 (CRS_DV/MODE2)
unnamed: RP8.6 (R3.2), U23.10 (RXER/PHYAD0)
unnamed: RP8.7 (R2.2), U23.8 (RXD0/MODE0)
unnamed: RP8.8 (R1.2), U23.7 (RXD1/MODE1)
unnamed: RP10.5 (R4.2), U23.18 (TXD1)
unnamed: RP10.6 (R3.2), U23.17 (TXD0)
unnamed: RP10.7 (R2.2), U23.16 (TXEN)
REFCLK: R128.2
RX+: J1.3 (RD+), R10.2, U23.23 (RX+), U24.3 (I/O2)
RX-: J1.6 (RD-), R9.2, U23.22 (RX-), U24.1 (I/O1)
RXD0: RP8.2 (R2.1)
RXD1: RP8.1 (R1.1)
RXER: RP8.3 (R3.1)
TX+: J1.1 (TD+), R13.2, U23.21 (TX+), U24.6 (I/O4)
TX-: J1.2 (TD-), R12.2, U23.20 (TX-), U24.4 (I/O3)
TXD0: RP10.3 (R3.1)
TXD1: RP10.4 (R4.1)
TXEN: RP10.2 (R2.1)
~RST: R114.1, U23.15 (~RST)
