Marco-Peter/Morgenmuffel/schema/JTAG.kicad_sch

## KiCad design schema/JTAG.kicad_sch (2022-03-19)

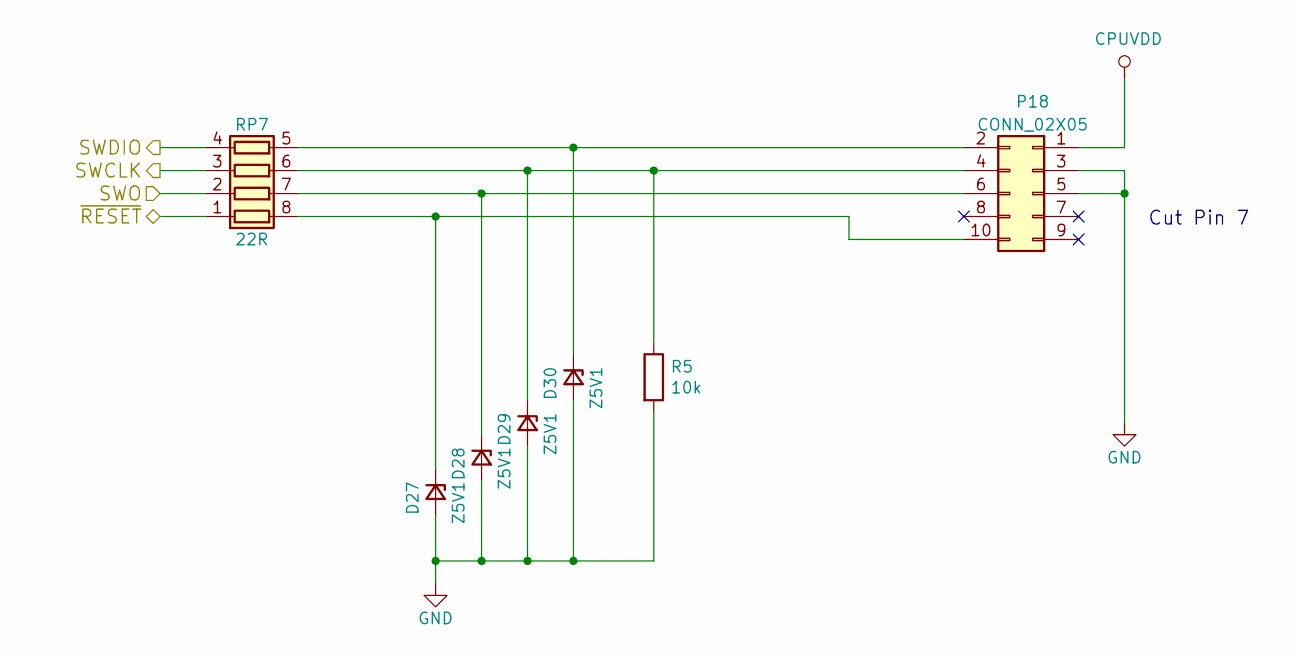
[picture p11: schematic JTAG.kicad_sch]

Parts:
D27, D28, D29, D30: Z5V1; SOD-523
P18: CONN_02X05; M50-3610542
R5: 10k; R_0603_HandSoldering
RP7: 22R; R_Array_Convex_4x0603

Connections:
CPUVDD: P18.1
GND: D27.2 (A), D28.2 (A), D29.2 (A), D30.2 (A), P18.3, P18.5, R5.2
unnamed: D27.1 (K), P18.10, RP7.8 (R1.2)
unnamed: D28.1 (K), P18.6, RP7.7 (R2.2)
unnamed: D29.1 (K), P18.4, R5.1, RP7.6 (R3.2)
unnamed: D30.1 (K), P18.2, RP7.5 (R4.2)
SWCLK: RP7.3 (R3.1)
SWDIO: RP7.4 (R4.1)
SWO: RP7.2 (R2.1)
~RESET: RP7.1 (R1.1)

Notes on the sheet:
Cut Pin 7
