Marco-Peter/Morgenmuffel/schema/Mainboard.kicad_sch

## KiCad design schema/Mainboard.kicad_sch (2022-03-19)

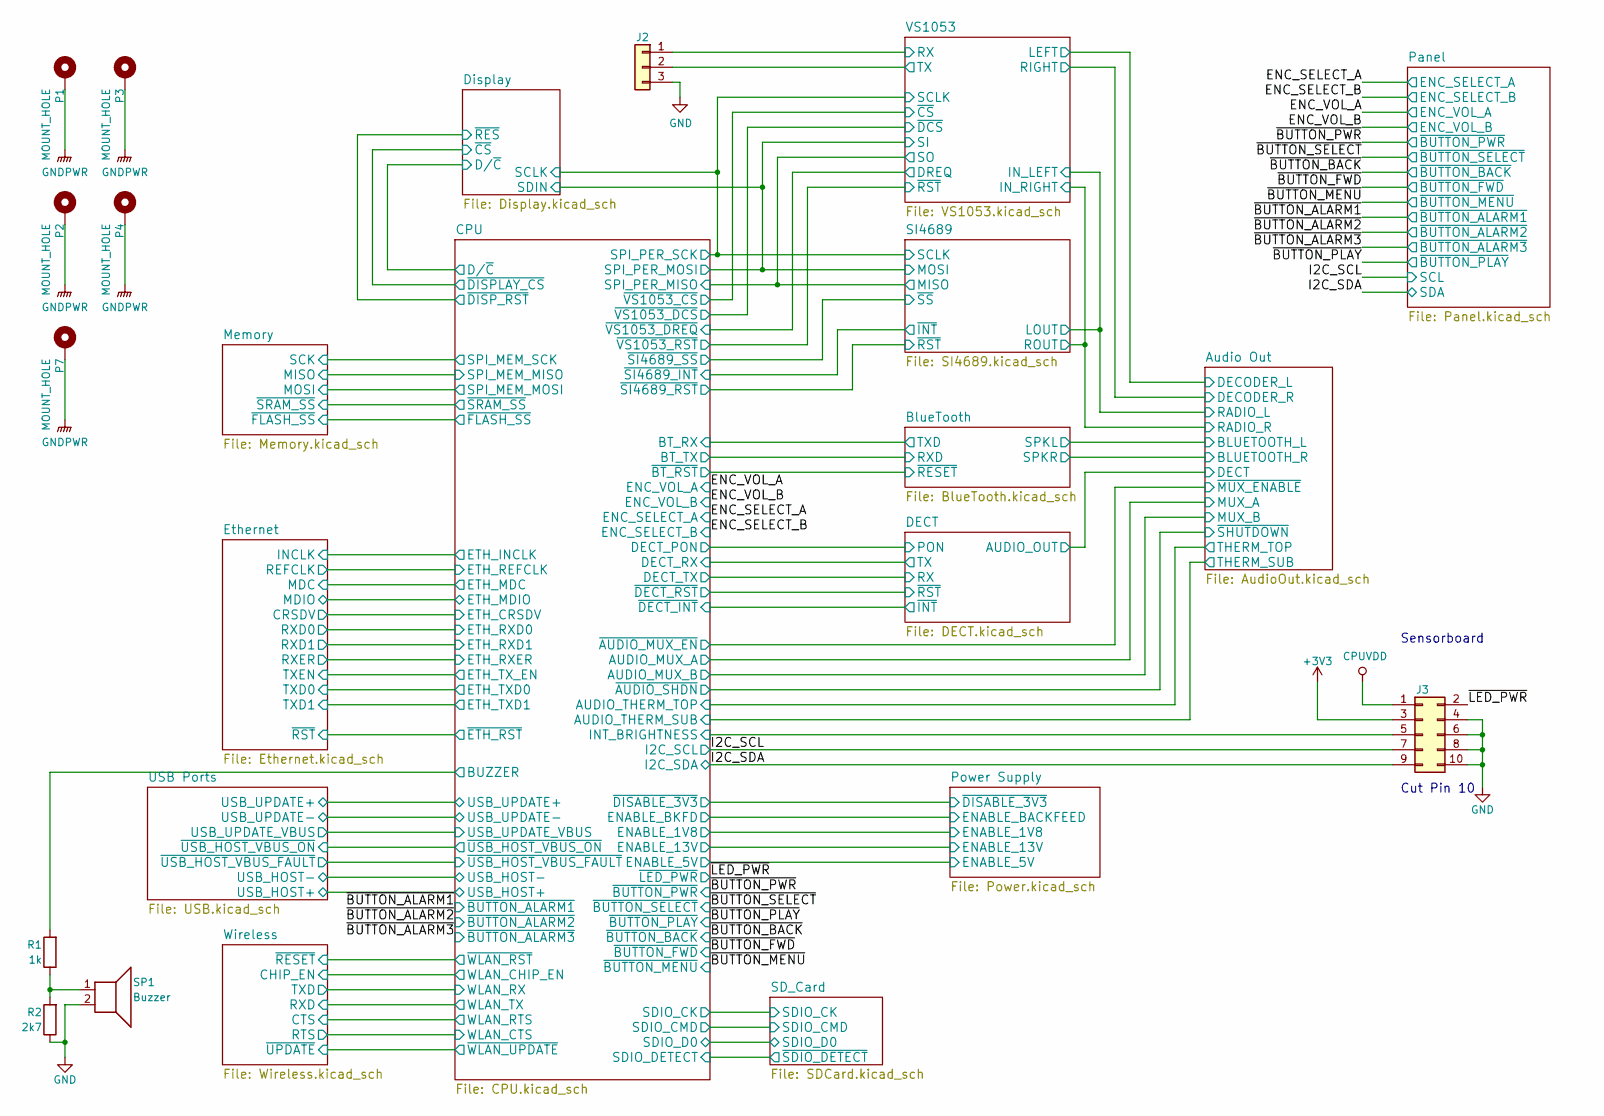
[picture p12: schematic Mainboard.kicad_sch]

Parts:
J2: CONN_01X03; Pin_Header_Straight_1x03
J3: CONN_02X05; IDC_Header_Straight_10pins
P1, P2, P3, P4, P7: MOUNT_HOLE; MountingHole_3.2mm_M3_Pad
R1: 1k; R_0603_HandSoldering
R2: 2k7; R_0603_HandSoldering
SP1: Buzzer; PKLCS1212E2000-R1

Connections:
+3V3: J3.3
BUZZER: R1.2
CPUVDD: J3.1
GND: J2.3, J3.4, J3.6, J3.8, J3.10, R2.1, SP1.2
GNDPWR: P1.1, P2.1, P3.1, P4.1, P7.1
I2C_SCL: J3.7
I2C_SDA: J3.9
INT_BRIGHTNESS: J3.5
unnamed: R1.1, R2.2, SP1.1
RX: J2.1
TX: J2.2
~LED_PWR: J3.2

Notes on the sheet:
Cut Pin 10
Sensorboard
