Marco-Peter/Morgenmuffel/schema/Memory.kicad_sch

## KiCad design schema/Memory.kicad_sch (2022-03-19)

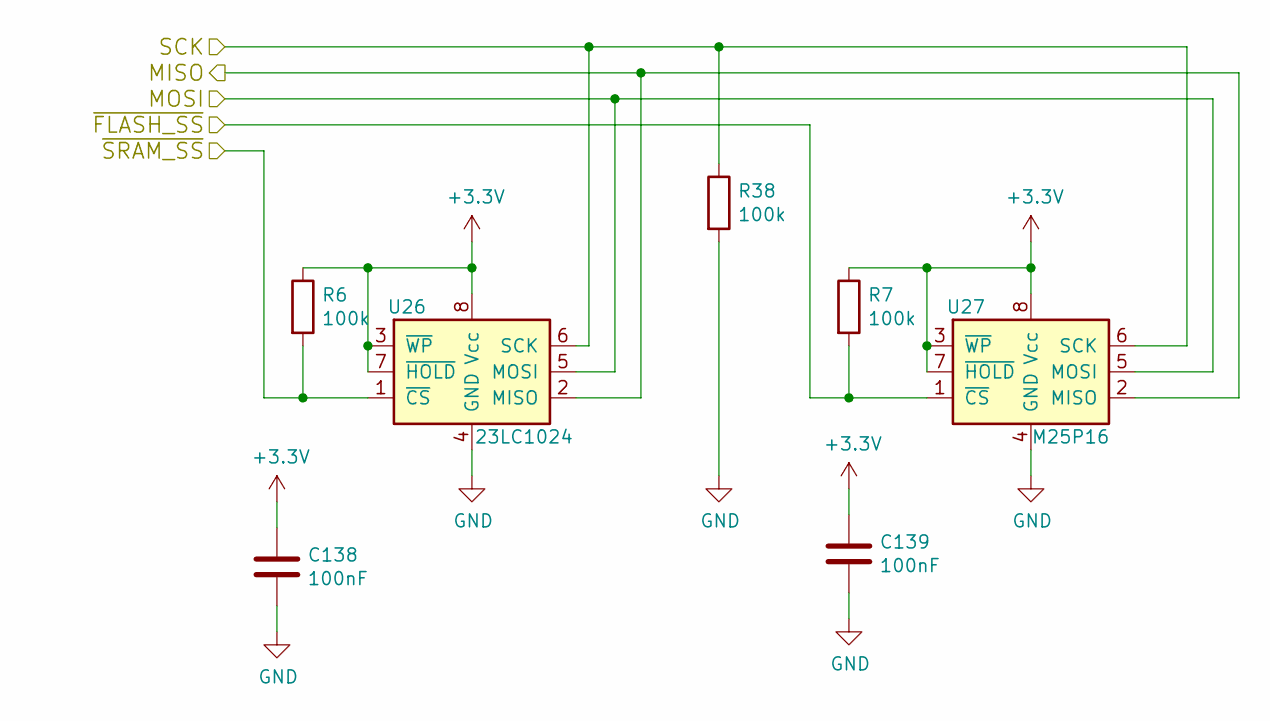
[picture p13: schematic Memory.kicad_sch]

Parts:
C138, C139: 100nF; C_0603_HandSoldering
R6, R7, R38: 100k; R_0603_HandSoldering
U26: 23LC1024; SOIC-8_3.9x4.9mm_Pitch1.27mm
U27: M25P16; SOIC-8_3.9x4.9mm_Pitch1.27mm

Connections:
+3.3V: C138.1, C139.1, R6.1, R7.1, U26.3 (~WP), U26.7 (~HOLD), U26.8 (Vcc), U27.3 (~WP), U27.7 (~HOLD), U27.8 (Vcc)
GND: C138.2, C139.2, R38.2, U26.4 (GND), U27.4 (GND)
MISO: U26.2 (MISO), U27.2 (MISO)
MOSI: U26.5 (MOSI), U27.5 (MOSI)
SCK: R38.1, U26.6 (SCK), U27.6 (SCK)
~FLASH_SS: R7.2, U27.1 (~CS)
~SRAM_SS: R6.2, U26.1 (~CS)
