Marco-Peter/Morgenmuffel/schema/Panel.kicad_sch

## KiCad design schema/Panel.kicad_sch (2022-03-19)

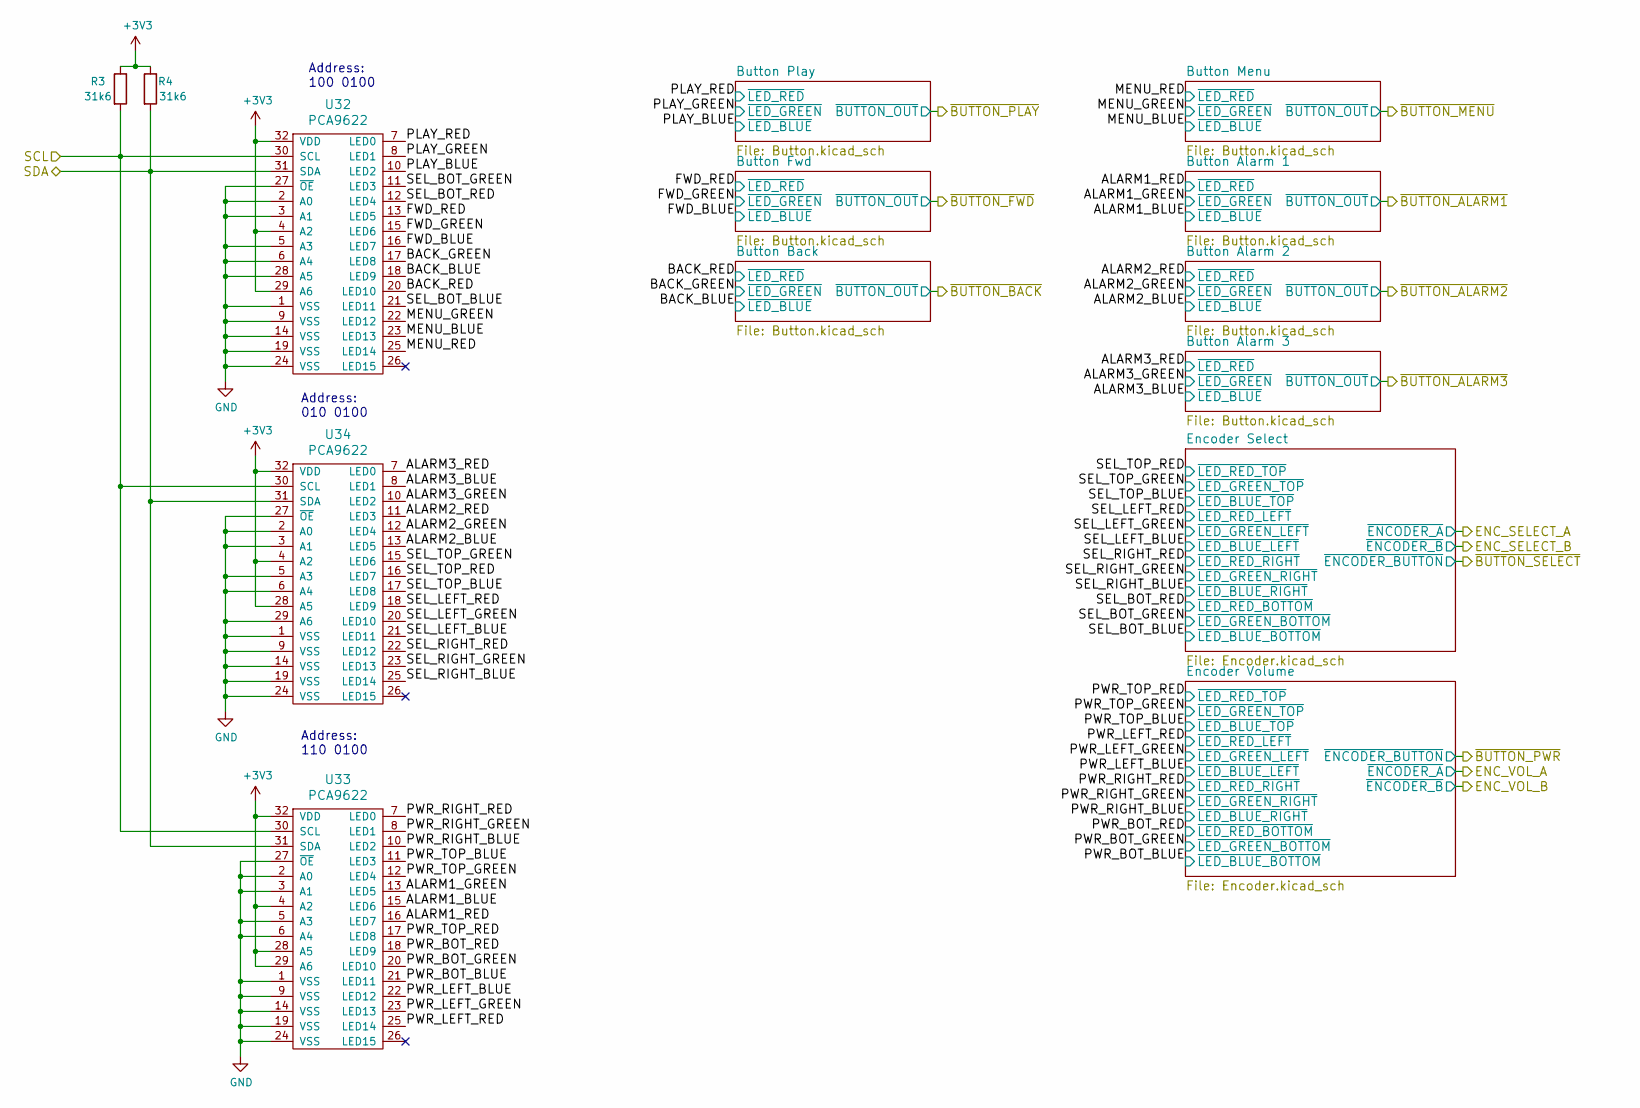
[picture p14: schematic Panel.kicad_sch]

Parts:
R3, R4: 31k6; R_0603_HandSoldering
U32, U33, U34: PCA9622; TSSOP-32_6.1x11mm_Pitch0.65mm

Connections:
+3V3: R3.1, R4.1, U32.4 (A2), U32.29 (A6), U32.32 (VDD), U33.4 (A2), U33.28 (A5), U33.29 (A6), U33.32 (VDD), U34.4 (A2), U34.28 (A5), U34.32 (VDD)
ALARM1_BLUE: U33.15 (LED6)
ALARM1_GREEN: U33.13 (LED5)
ALARM1_RED: U33.16 (LED7)
ALARM2_BLUE: U34.13 (LED5)
ALARM2_GREEN: U34.12 (LED4)
ALARM2_RED: U34.11 (LED3)
ALARM3_BLUE: U34.8 (LED1)
ALARM3_GREEN: U34.10 (LED2)
ALARM3_RED: U34.7 (LED0)
BACK_BLUE: U32.18 (LED9)
BACK_GREEN: U32.17 (LED8)
BACK_RED: U32.20 (LED10)
FWD_BLUE: U32.16 (LED7)
FWD_GREEN: U32.15 (LED6)
FWD_RED: U32.13 (LED5)
GND: U32.1 (VSS), U32.2 (A0), U32.3 (A1), U32.5 (A3), U32.6 (A4), U32.9 (VSS), U32.14 (VSS), U32.19 (VSS), U32.24 (VSS), U32.27 (~OE), U32.28 (A5), U33.1 (VSS), U33.2 (A0), U33.3 (A1), U33.5 (A3), U33.6 (A4), U33.9 (VSS), U33.14 (VSS), U33.19 (VSS), U33.24 (VSS), U33.27 (~OE), U34.1 (VSS), U34.2 (A0), U34.3 (A1), U34.5 (A3), U34.6 (A4), U34.9 (VSS), U34.14 (VSS), U34.19 (VSS), U34.24 (VSS), U34.27 (~OE), U34.29 (A6)
MENU_BLUE: U32.23 (LED13)
MENU_GREEN: U32.22 (LED12)
MENU_RED: U32.25 (LED14)
PLAY_BLUE: U32.10 (LED2)
PLAY_GREEN: U32.8 (LED1)
PLAY_RED: U32.7 (LED0)
PWR_BOT_BLUE: U33.21 (LED11)
PWR_BOT_GREEN: U33.20 (LED10)
PWR_BOT_RED: U33.18 (LED9)
PWR_LEFT_BLUE: U33.22 (LED12)
PWR_LEFT_GREEN: U33.23 (LED13)
PWR_LEFT_RED: U33.25 (LED14)
PWR_RIGHT_BLUE: U33.10 (LED2)
PWR_RIGHT_GREEN: U33.8 (LED1)
PWR_RIGHT_RED: U33.7 (LED0)
PWR_TOP_BLUE: U33.11 (LED3)
PWR_TOP_GREEN: U33.12 (LED4)
PWR_TOP_RED: U33.17 (LED8)
SCL: R3.2, U32.30 (SCL), U33.30 (SCL), U34.30 (SCL)
SDA: R4.2, U32.31 (SDA), U33.31 (SDA), U34.31 (SDA)
SEL_BOT_BLUE: U32.21 (LED11)
SEL_BOT_GREEN: U32.11 (LED3)
SEL_BOT_RED: U32.12 (LED4)
SEL_LEFT_BLUE: U34.21 (LED11)
SEL_LEFT_GREEN: U34.20 (LED10)
SEL_LEFT_RED: U34.18 (LED9)
SEL_RIGHT_BLUE: U34.25 (LED14)
SEL_RIGHT_GREEN: U34.23 (LED13)
SEL_RIGHT_RED: U34.22 (LED12)
SEL_TOP_BLUE: U34.17 (LED8)
SEL_TOP_GREEN: U34.15 (LED6)
SEL_TOP_RED: U34.16 (LED7)

Notes on the sheet:
Address: 110 0100
Address: 010 0100
Address: 100 0100
