Marco-Peter/Morgenmuffel/schema/Power.kicad_sch

## KiCad design schema/Power.kicad_sch (2022-03-19)

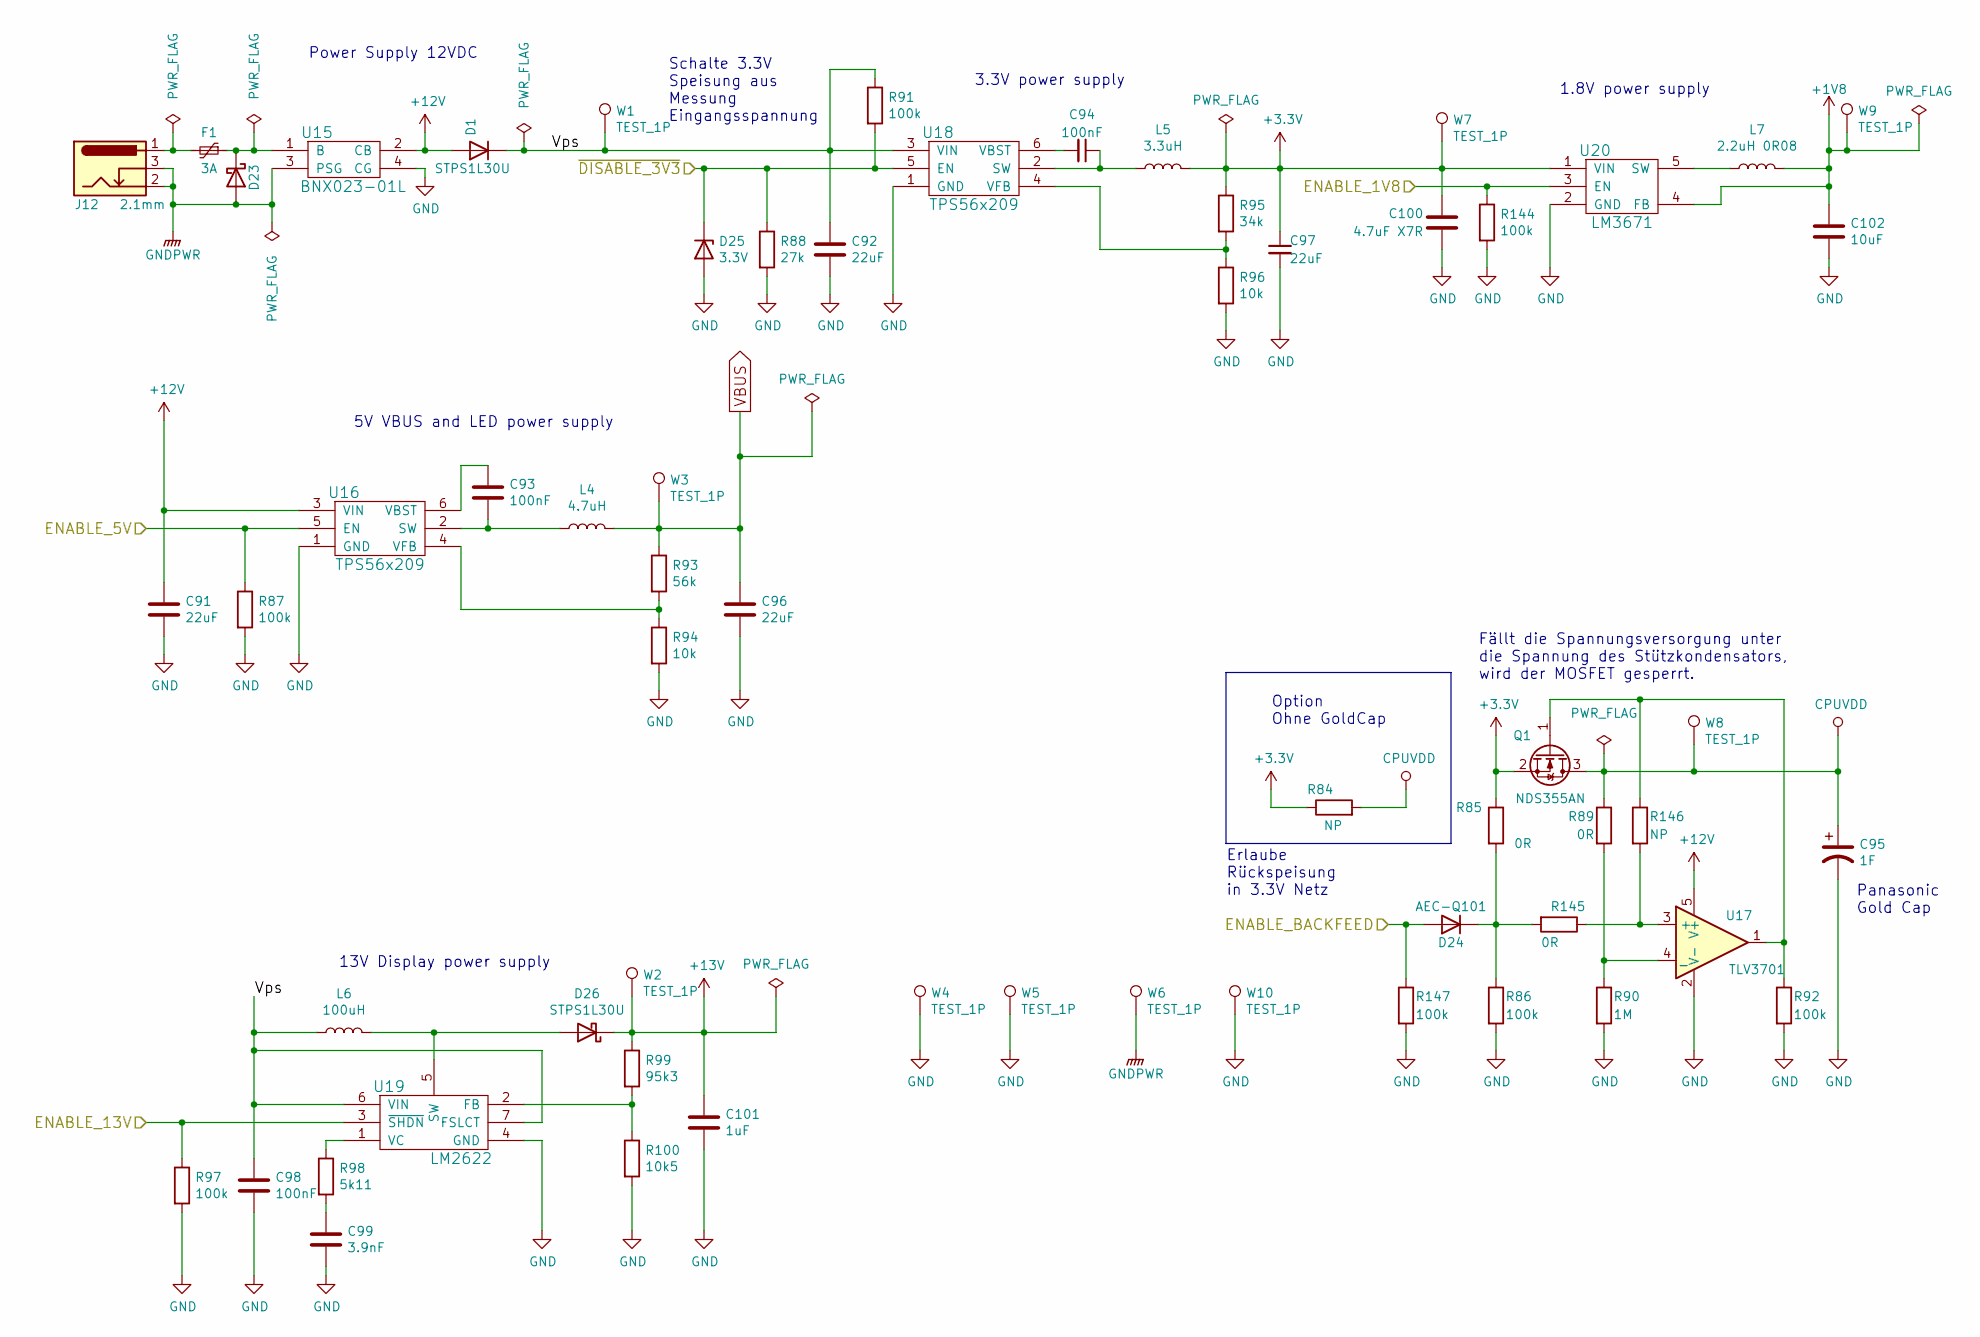
[picture p15: schematic Power.kicad_sch]

Parts:
C91, C92, C96, C97: 22uF; C_1206_HandSoldering
C93, C94, C98: 100nF; C_0603_HandSoldering
C95: 1F; EEC-RG0V105V
C99: 3.9nF; C_0603_HandSoldering
C100: 4.7uF X7R; C_1206_HandSoldering
C101: 1uF; C_0603_HandSoldering
C102: 10uF; C_1206_HandSoldering
D1, D26: STPS1L30U; SMB_Handsoldering
D23: SMA6J12A; SMA_Handsoldering
D24: AEC-Q101; C_1206_HandSoldering
D25: 3.3V; SOD-523
F1: 3A; R_1206_HandSoldering
J12: 2.1mm; FC68148S
L4: 4.7uH; Bourns_SRN6045
L5: 3.3uH; Choke_Panasonic_10mm
L6: 100uH; C_1210_HandSoldering
L7: 2.2uH 0R08; Inductor_3x2mm_Wuerth
Q1: NDS355AN; SOT-23_Handsoldering
R84, R146: NP; R_0603_HandSoldering
R85, R89, R145: 0R; R_0603_HandSoldering
R86, R87, R91, R92, R97, R144, R147: 100k; R_0603_HandSoldering
R88: 27k; R_0603_HandSoldering
R90: 1M; R_0603_HandSoldering
R93: 56k; R_0603_HandSoldering; Tolerance 1%
R94, R96: 10k; R_0603_HandSoldering; Tolerance 1%
R95: 34k; R_0603_HandSoldering; Tolerance 1%
R98: 5k11; R_0603_HandSoldering
R99: 95k3; R_0603_HandSoldering
R100: 10k5; R_0603_HandSoldering
U15: BNX023-01L; BNX02x
U16, U18: TPS56x209; SOT-23-6
U17: TLV3701; SOT-23-5
U19: LM2622; MSOP-8_3x3mm_Pitch0.65mm
U20: LM3671; SOT-23-5
W1, W2, W3, W4, W5, W6, W7, W8, W9, W10: TEST_1P; PINTST

Connections:
+1V8: C102.1, L7.2, U20.4 (FB), W9.1
+3.3V: C97.1, C100.1, L5.2, Q1.2 (S), R84.1, R85.1, R95.1, U20.1 (VIN), W7.1
+12V: C91.1, D1.2 (A), U15.2 (CB), U16.3 (VIN), U17.5 (V+)
+13V: C101.1, D26.1 (K), R99.1, W2.1
CPUVDD: C95.1, Q1.3 (D), R84.2, R89.1, W8.1
ENABLE_1V8: R144.1, U20.3 (EN)
ENABLE_5V: R87.1, U16.5 (EN)
ENABLE_13V: R97.1, U19.3 (~SHDN)
ENABLE_BACKFEED: D24.2 (A), R147.1
GND: C91.2, C92.2, C95.2, C96.2, C97.2, C98.2, C99.2, C100.2, C101.2, C102.2, D25.2 (A), R86.2, R87.2, R88.2, R90.2, R92.2, R94.2, R96.2, R97.2, R100.2, R144.2, R147.2, U15.4 (CG), U16.1 (GND), U17.2 (V-), U18.1 (GND), U19.4 (GND), U20.2 (GND), W4.1, W5.1, W10.1
GNDPWR: D23.2 (A), J12.2, J12.3, U15.3 (PSG), W6.1
unnamed: C93.1, U16.6 (VBST)
unnamed: C93.2, L4.1, U16.2 (SW)
unnamed: C94.1, L5.1, U18.2 (SW)
unnamed: C94.2, U18.6 (VBST)
unnamed: C99.1, R98.2
unnamed: D23.1 (K), F1.1, U15.1 (B)
unnamed: D24.1 (K), R85.2, R86.1, R145.2
unnamed: D26.2 (A), L6.2, U19.5 (SW)
unnamed: F1.2, J12.1
unnamed: L7.1, U20.5 (SW)
unnamed: Q1.1 (G), R92.1, R146.1, U17.1
unnamed: R89.2, R90.1, U17.4 (_)
unnamed: R93.2, R94.1, U16.4 (VFB)
unnamed: R95.2, R96.1, U18.4 (VFB)
unnamed: R98.1, U19.1 (VC)
unnamed: R99.2, R100.1, U19.2 (FB)
unnamed: R145.1, R146.2, U17.3 (+)
VBUS: C96.1, L4.2, R93.1, W3.1
Vps: C92.1, C98.1, D1.1 (K), L6.1, R91.1, U18.3 (VIN), U19.6 (VIN), U19.7 (FSLCT), W1.1
~DISABLE_3V3: D25.1 (K), R88.1, R91.2, U18.5 (EN)

Notes on the sheet:
Power Supply 12VDC
13V Display power supply
Panasonic Gold Cap
3.3V power supply
Option Ohne GoldCap
5V VBUS and LED power supply
Fällt die Spannungsversorgung unter die Spannung des Stützkondensators, wird der MOSFET gesperrt.
Schalte 3.3V Speisung aus Messung Eingangsspannung
1.8V power supply
Erlaube Rückspeisung in 3.3V Netz
