Marco-Peter/Morgenmuffel/schema/SDCard.kicad_sch

## KiCad design schema/SDCard.kicad_sch (2022-03-19)

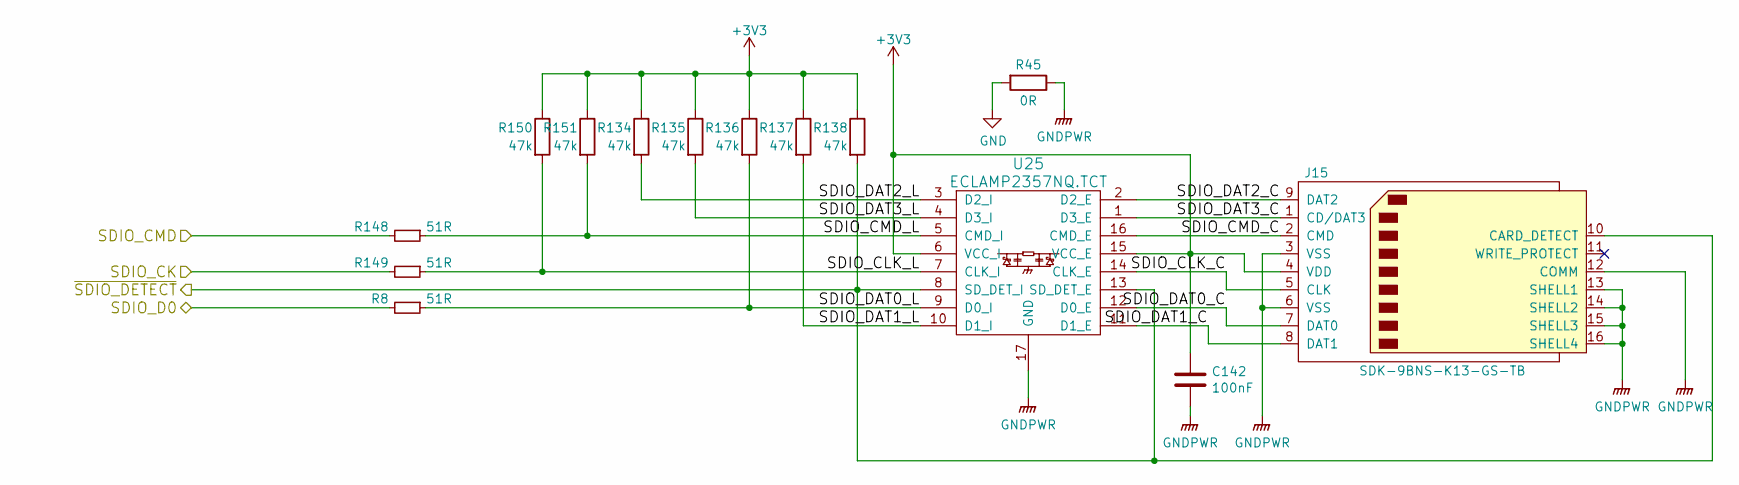
[picture p16: schematic SDCard.kicad_sch]

Parts:
C142: 100nF; C_0603_HandSoldering
J15: SDK-9BNS-K13-GS-TB; JST_SDK-9BNS-K13-GS-TB
R8, R148, R149: 51R; R_0603_HandSoldering
R45: 0R; R_0603_HandSoldering
R134, R135, R136, R137, R138, R150, R151: 47k; R_0603_HandSoldering
U25: ECLAMP2357NQ.TCT; QFN-16-1EP_3x3mm_Pitch0.5mm

Connections:
+3V3: C142.1, J15.4 (VDD), R134.1, R135.1, R136.1, R137.1, R138.1, R150.1, R151.1, U25.6 (VCC_I), U25.15 (VCC_E)
GND: R45.2
GNDPWR: C142.2, J15.3 (VSS), J15.6 (VSS), J15.12 (COMM), J15.13 (SHELL1), J15.14 (SHELL2), J15.15 (SHELL3), J15.16 (SHELL4), R45.1, U25.17 (GND)
SDIO_CK: R149.2
SDIO_CLK_C: J15.5 (CLK), U25.14 (CLK_E)
SDIO_CLK_L: R149.1, R150.2, U25.7 (CLK_I)
SDIO_CMD: R148.2
SDIO_CMD_C: J15.2 (CMD), U25.16 (CMD_E)
SDIO_CMD_L: R148.1, R151.2, U25.5 (CMD_I)
SDIO_D0: R8.2
SDIO_DAT0_C: J15.7 (DAT0), U25.12 (D0_E)
SDIO_DAT0_L: R8.1, R136.2, U25.9 (D0_I)
SDIO_DAT1_C: J15.8 (DAT1), U25.11 (D1_E)
SDIO_DAT1_L: R137.2, U25.10 (D1_I)
SDIO_DAT2_C: J15.9 (DAT2), U25.2 (D2_E)
SDIO_DAT2_L: R134.2, U25.3 (D2_I)
SDIO_DAT3_C: J15.1 (CD/DAT3), U25.1 (D3_E)
SDIO_DAT3_L: R135.2, U25.4 (D3_I)
~SDIO_DETECT: J15.10 (CARD_DETECT), R138.2, U25.8 (SD_DET_I), U25.13 (SD_DET_E)
