Marco-Peter/Morgenmuffel/schema/SI4689.kicad_sch

## KiCad design schema/SI4689.kicad_sch (2022-03-19)

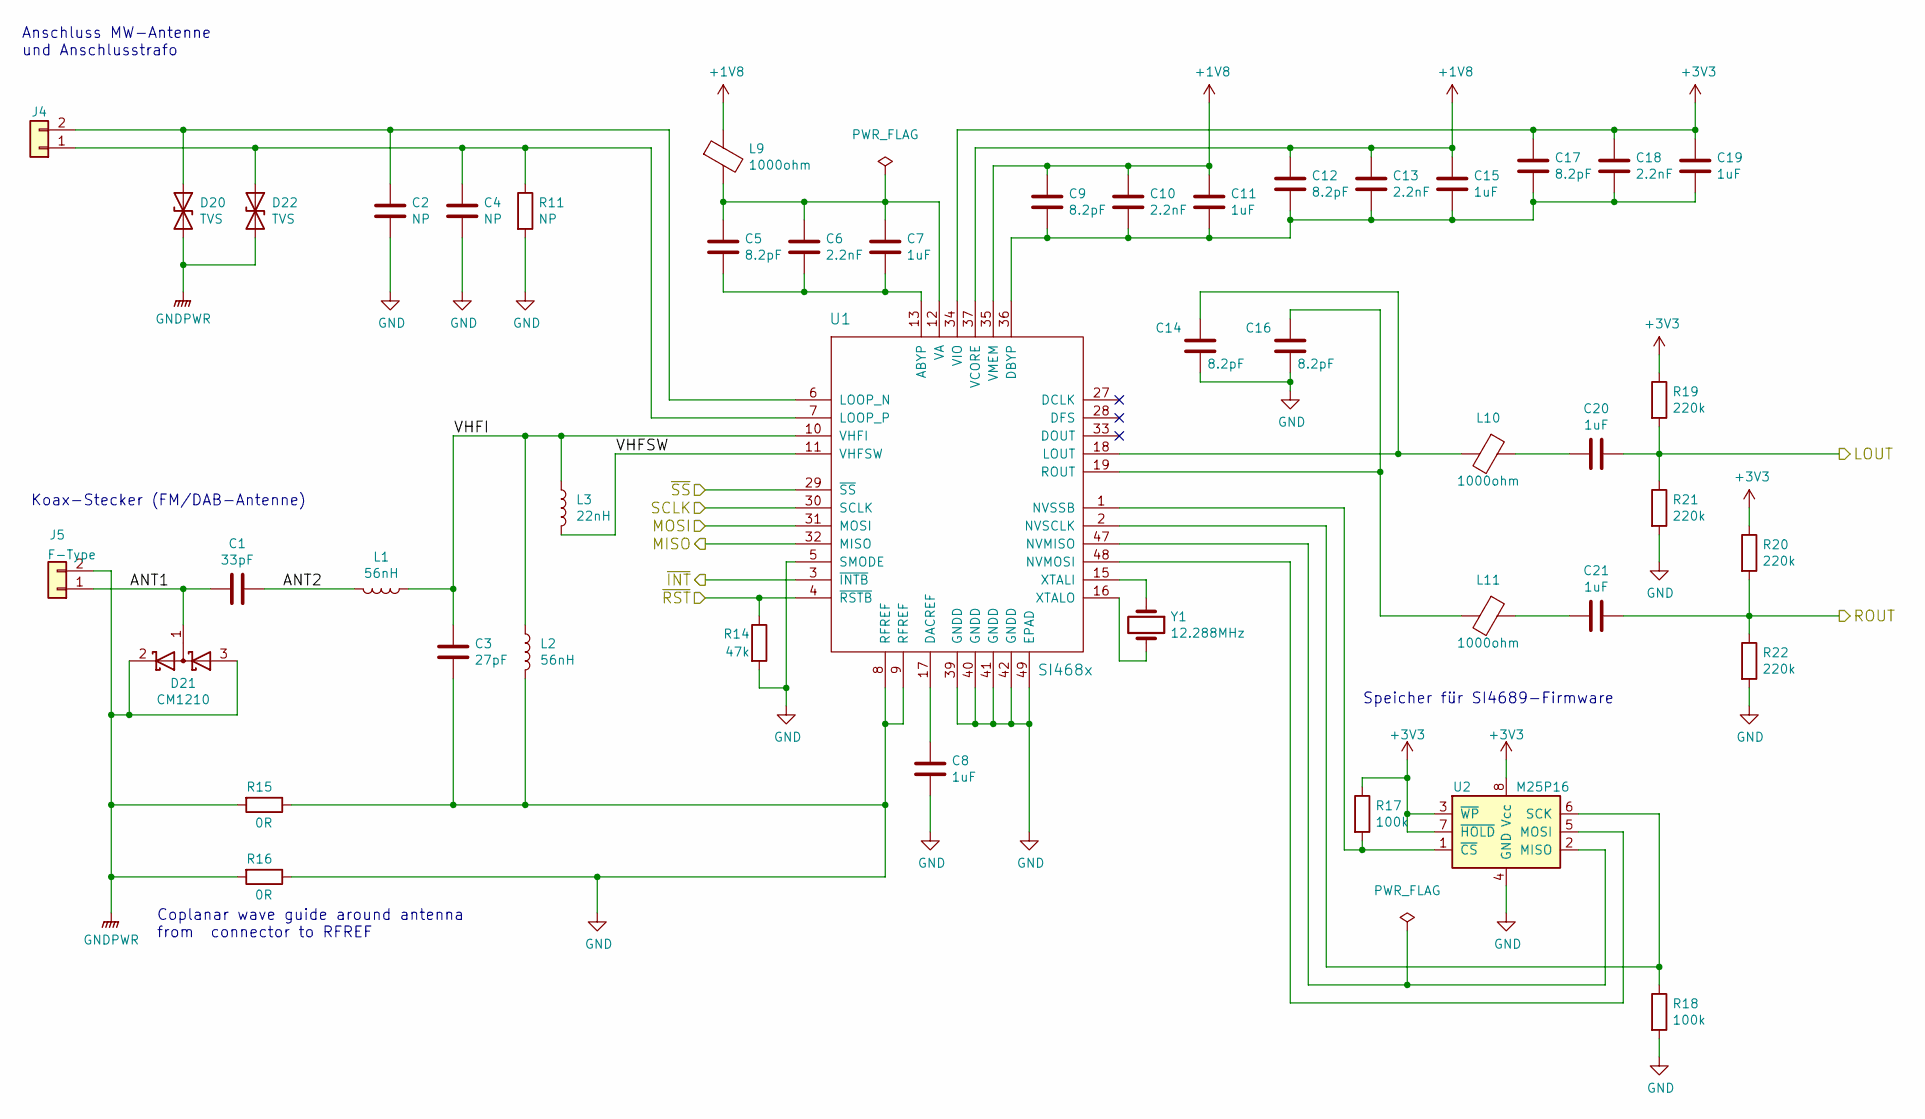
[picture p17: schematic SI4689.kicad_sch]

Parts:
C1: 33pF; C_0603_HandSoldering
C2, C4: NP; C_0603_HandSoldering
C3: 27pF; C_0603_HandSoldering
C5, C9, C12, C14, C16, C17: 8.2pF; C_0603_HandSoldering
C6, C10, C13, C18: 2.2nF; C_0603_HandSoldering
C7, C8, C11, C15, C19, C20, C21: 1uF; C_0603_HandSoldering
D20, D22: TVS; R_0603_HandSoldering
D21: CM1210; SOT-23
J4: CONN_01X02; Pin_Header_Straight_1x02
J5: F-Type; F-Connector
L1, L2: 56nH; R_0603_HandSoldering
L3: 22nH; R_0603_HandSoldering
L9, L10, L11: 1000ohm; R_0603_HandSoldering
R11: NP; R_0603_HandSoldering
R14: 47k; R_0603_HandSoldering
R15, R16: 0R; R_0603_HandSoldering
R17, R18: 100k; R_0603_HandSoldering
R19, R20, R21, R22: 220k; R_0603_HandSoldering
U1: SI468x; QFN_48
U2: M25P16; SOIC-8_3.9x4.9mm_Pitch1.27mm
Y1: 12.288MHz; Crystal_HC49-SD_SMD

Connections:
+1V8: C9.1, C10.1, C11.1, C12.1, C13.1, C15.1, L9.1, U1.35 (VMEM), U1.37 (VCORE)
+3V3: C17.1, C18.1, C19.1, R17.1, R19.1, R20.1, U1.34 (VIO), U2.3 (~WP), U2.7 (~HOLD), U2.8 (Vcc)
ANT1: C1.2, D21.1 (common), J5.1
ANT2: C1.1, L1.2
GND: C2.2, C3.2, C4.2, C8.2, C14.1, C16.1, L2.2, R11.2, R14.2, R15.1, R16.1, R18.2, R21.2, R22.2, U1.5 (SMODE), U1.8 (RFREF), U1.9 (RFREF), U1.39 (GNDD), U1.40 (GNDD), U1.41 (GNDD), U1.42 (GNDD), U1.49 (EPAD), U2.4 (GND)
GNDPWR: D20.2 (A2), D21.2 (K), D21.3 (A), D22.2 (A2), J5.2, R15.2, R16.2
LOUT: C20.1, R19.2, R21.1
MISO: U1.32 (MISO)
MOSI: U1.31 (MOSI)
unnamed: C2.1, D20.1 (A1), J4.2, U1.6 (LOOP_N)
unnamed: C4.1, D22.1 (A1), J4.1, R11.1, U1.7 (LOOP_P)
unnamed: C5.1, C6.1, C7.1, L9.2, U1.12 (VA)
unnamed: C5.2, C6.2, C7.2, U1.13 (ABYP)
unnamed: C8.1, U1.17 (DACREF)
unnamed: C9.2, C10.2, C11.2, C12.2, C13.2, C15.2, C17.2, C18.2, C19.2, U1.36 (DBYP)
unnamed: C14.2, L10.2, U1.18 (LOUT)
unnamed: C16.2, L11.2, U1.19 (ROUT)
unnamed: C20.2, L10.1
unnamed: C21.2, L11.1
unnamed: R17.2, U1.1 (NVSSB), U2.1 (~CS)
unnamed: R18.1, U1.2 (NVSCLK), U2.6 (SCK)
unnamed: U1.15 (XTALI), Y1.1
unnamed: U1.16 (XTALO), Y1.2
unnamed: U1.47 (NVMISO), U2.2 (MISO)
unnamed: U1.48 (NVMOSI), U2.5 (MOSI)
ROUT: C21.1, R20.2, R22.1
SCLK: U1.30 (SCLK)
VHFI: C3.1, L1.1, L2.1, L3.1, U1.10 (VHFI)
VHFSW: L3.2, U1.11 (VHFSW)
~INT: U1.3 (~INTB)
~RST: R14.1, U1.4 (~RSTB)
~SS: U1.29 (~SS)

Notes on the sheet:
Koax-Stecker (FM/DAB-Antenne)
Coplanar wave guide around antenna from connector to RFREF
Speicher für SI4689-Firmware
Anschluss MW-Antenne und Anschlusstrafo
