Marco-Peter/Morgenmuffel/schema/USB.kicad_sch

## KiCad design schema/USB.kicad_sch (2022-03-19)

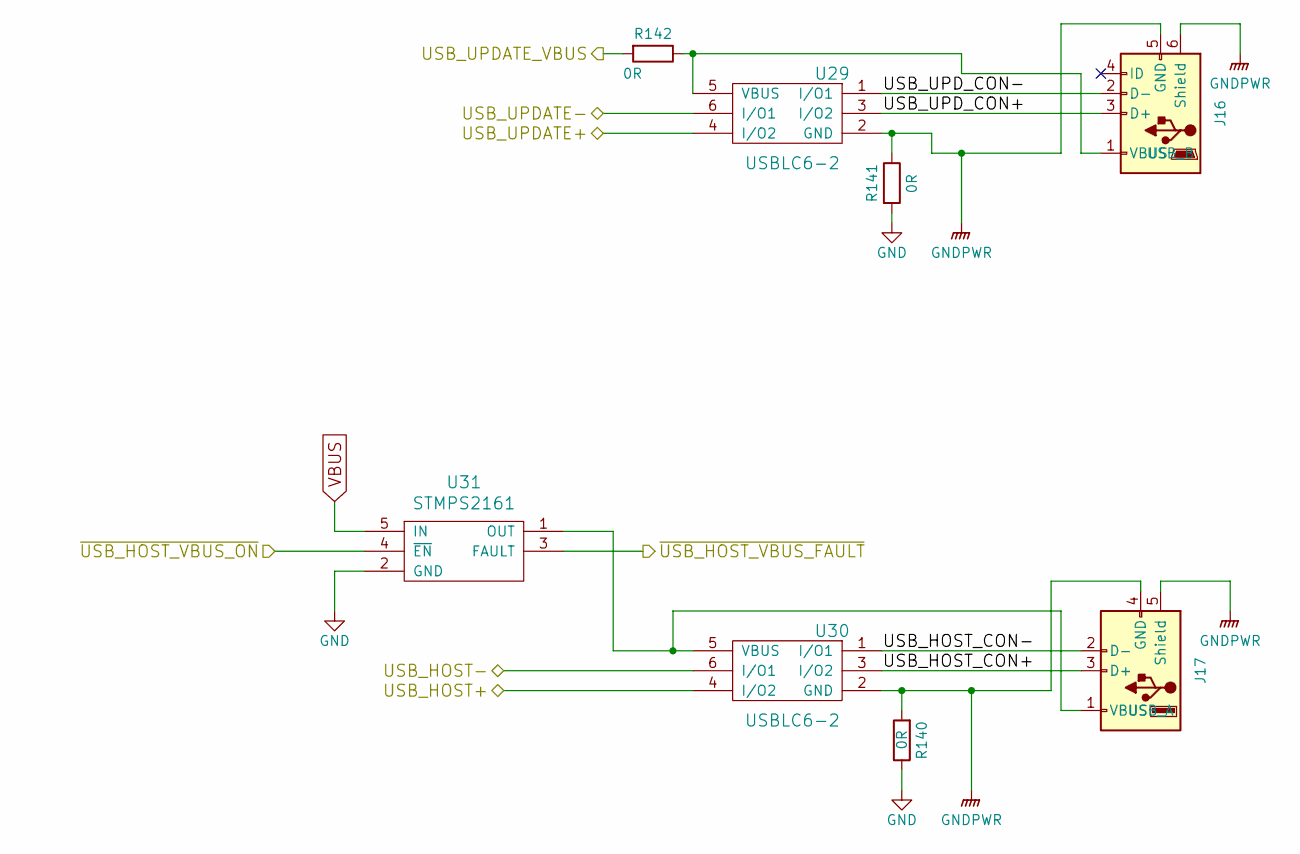
[picture p18: schematic USB.kicad_sch]

Parts:
J16: USB_B; USB_Micro_SMD
J17: USB_A; USB_A_SMD
R140, R141, R142: 0R; R_0603_HandSoldering
U29, U30: USBLC6-2; SOT-23-6_Handsoldering
U31: STMPS2161; SOT-23-5

Connections:
GND: R140.1, R141.2, U31.2 (GND)
GNDPWR: J16.5 (GND), J16.6 (Shield), J17.4 (GND), J17.5 (Shield), R140.2, R141.1, U29.2 (GND), U30.2 (GND)
unnamed: J16.1 (VBUS), R142.1, U29.5 (VBUS)
unnamed: J17.1 (VBUS), U30.5 (VBUS), U31.1 (OUT)
USB_HOST+: U30.4 (I/O2)
USB_HOST-: U30.6 (I/O1)
USB_HOST_CON+: J17.3 (D+), U30.3 (I/O2)
USB_HOST_CON-: J17.2 (D-), U30.1 (I/O1)
USB_UPDATE+: U29.4 (I/O2)
USB_UPDATE-: U29.6 (I/O1)
USB_UPDATE_VBUS: R142.2
USB_UPD_CON+: J16.3 (D+), U29.3 (I/O2)
USB_UPD_CON-: J16.2 (D-), U29.1 (I/O1)
VBUS: U31.5 (IN)
~USB_HOST_VBUS_FAULT: U31.3 (FAULT)
~USB_HOST_VBUS_ON: U31.4 (~EN)
