Marco-Peter/Morgenmuffel/schema/VS1053.kicad_sch

## KiCad design schema/VS1053.kicad_sch (2022-03-19)

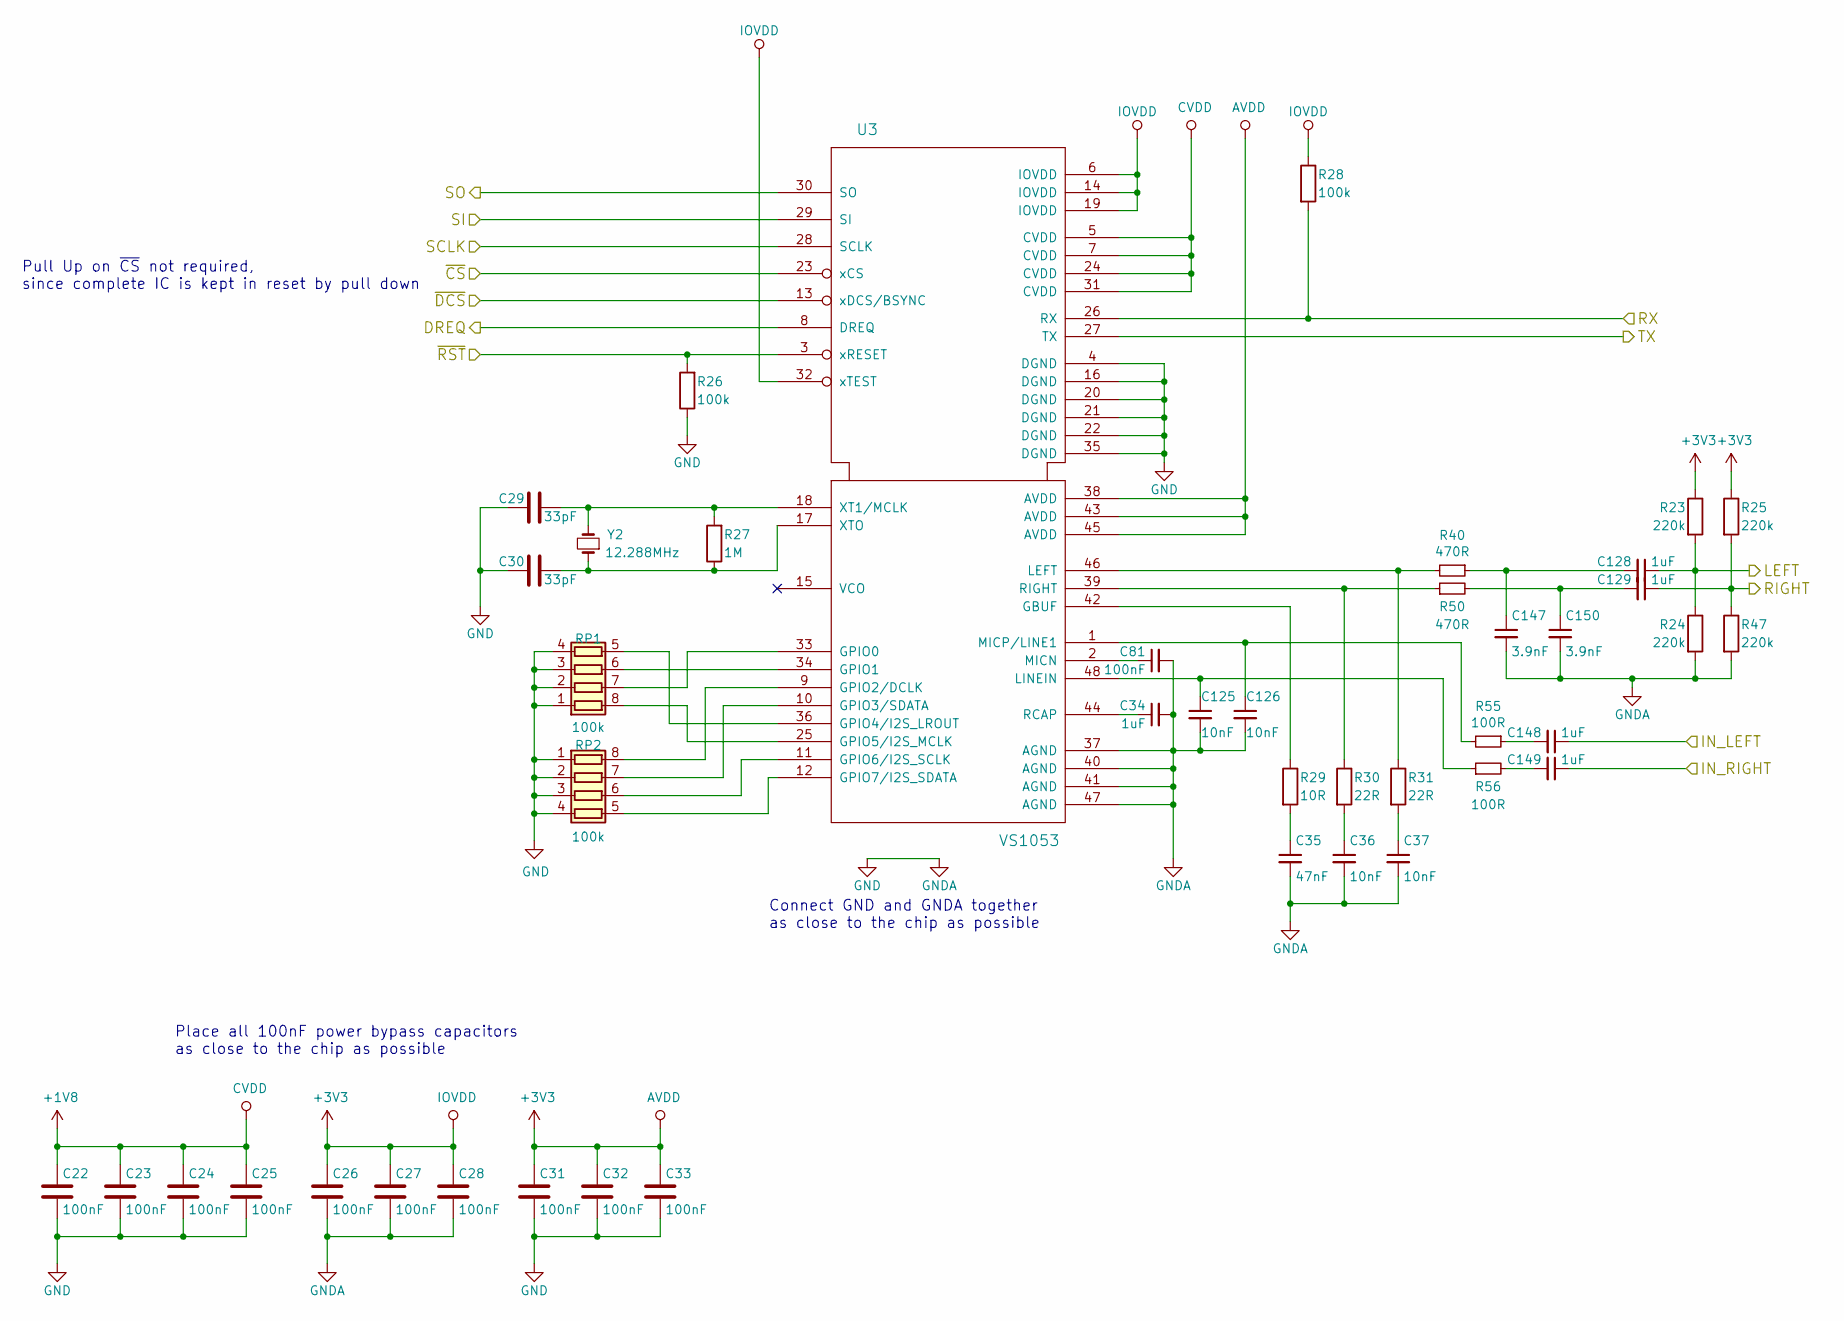
[picture p19: schematic VS1053.kicad_sch]

Parts:
C22, C23, C24, C25, C26, C27, C28, C31, C32, C33, C81: 100nF; C_0603_HandSoldering
C29, C30: 33pF; C_0603_HandSoldering
C34, C128, C129, C148, C149: 1uF; C_0603_HandSoldering
C35: 47nF; C_0603_HandSoldering
C36, C37, C125, C126: 10nF; C_0603_HandSoldering
C147, C150: 3.9nF; C_0603_HandSoldering
R23, R24, R25, R47: 220k; R_0603_HandSoldering
R26, R28: 100k; R_0603_HandSoldering
R27: 1M; R_0603_HandSoldering
R29: 10R; R_0603_HandSoldering
R30, R31: 22R; R_0603_HandSoldering
R40, R50: 470R; R_0603_HandSoldering
R55, R56: 100R; R_0603_HandSoldering
RP1, RP2: 100k; R_Array_Convex_4x0603
U3: VS1053; LQFP-48_7x7mm_Pitch0.5mm
Y2: 12.288MHz; Crystal_HC49-SD_SMD

Connections:
+1V8: C22.1, C23.1, C24.1, C25.1, U3.5 (CVDD), U3.7 (CVDD), U3.24 (CVDD), U3.31 (CVDD)
+3V3: C26.1, C27.1, C28.1, C31.1, C32.1, C33.1, R23.1, R25.1, R28.1, U3.6 (IOVDD), U3.14 (IOVDD), U3.19 (IOVDD), U3.32 (xTEST), U3.38 (AVDD), U3.43 (AVDD), U3.45 (AVDD)
DREQ: U3.8 (DREQ)
GND: C22.2, C23.2, C24.2, C25.2, C26.2, C27.2, C28.2, C29.2, C30.2, C31.2, C32.2, C33.2, C34.2, C35.2, C36.2, C37.2, C81.2, C125.2, C126.2, C147.2, C150.2, R24.2, R26.1, R47.2, RP1.1 (R1.1), RP1.2 (R2.1), RP1.3 (R3.1), RP1.4 (R4.1), RP2.1 (R1.1), RP2.2 (R2.1), RP2.3 (R3.1), RP2.4 (R4.1), U3.4 (DGND), U3.16 (DGND), U3.20 (DGND), U3.21 (DGND), U3.22 (DGND), U3.35 (DGND), U3.37 (AGND), U3.40 (AGND), U3.41 (AGND), U3.47 (AGND)
IN_LEFT: C148.1
IN_RIGHT: C149.1
LEFT: C128.1, R23.2, R24.1
unnamed: C29.1, R27.2, U3.18 (XT1/MCLK), Y2.2
unnamed: C30.1, R27.1, U3.17 (XTO), Y2.1
unnamed: C34.1, U3.44 (RCAP)
unnamed: C35.1, R29.2
unnamed: C36.1, R30.2
unnamed: C37.1, R31.2
unnamed: C81.1, U3.2 (MICN)
unnamed: C125.1, R56.1, U3.48 (LINEIN)
unnamed: C126.1, R55.2, U3.1 (MICP/LINE1)
unnamed: C128.2, C147.1, R40.1
unnamed: C129.2, C150.1, R50.2
unnamed: C148.2, R55.1
unnamed: C149.2, R56.2
unnamed: R29.1, U3.42 (GBUF)
unnamed: R30.1, R50.1, U3.39 (RIGHT)
unnamed: R31.1, R40.2, U3.46 (LEFT)
unnamed: RP1.5 (R4.2), U3.36 (GPIO4/I2S_LROUT)
unnamed: RP1.6 (R3.2), U3.34 (GPIO1)
unnamed: RP1.7 (R2.2), U3.33 (GPIO0)
unnamed: RP1.8 (R1.2), U3.25 (GPIO5/I2S_MCLK)
unnamed: RP2.5 (R4.2), U3.12 (GPIO7/I2S_SDATA)
unnamed: RP2.6 (R3.2), U3.11 (GPIO6/I2S_SCLK)
unnamed: RP2.7 (R2.2), U3.10 (GPIO3/SDATA)
unnamed: RP2.8 (R1.2), U3.9 (GPIO2/DCLK)
RIGHT: C129.1, R25.2, R47.1
RX: R28.2, U3.26 (RX)
SCLK: U3.28 (SCLK)
SI: U3.29 (SI)
SO: U3.30 (SO)
TX: U3.27 (TX)
~CS: U3.23 (xCS)
~DCS: U3.13 (xDCS/BSYNC)
~RST: R26.2, U3.3 (xRESET)

Notes on the sheet:
Place all 100nF power bypass capacitors as close to the chip as possible
Connect GND and GNDA together as close to the chip as possible
Pull Up on ~{CS} not required, since complete IC is kept in reset by pull down
