Marco-Peter/Morgenmuffel/schema/Wireless.kicad_sch

## KiCad design schema/Wireless.kicad_sch (2022-03-19)

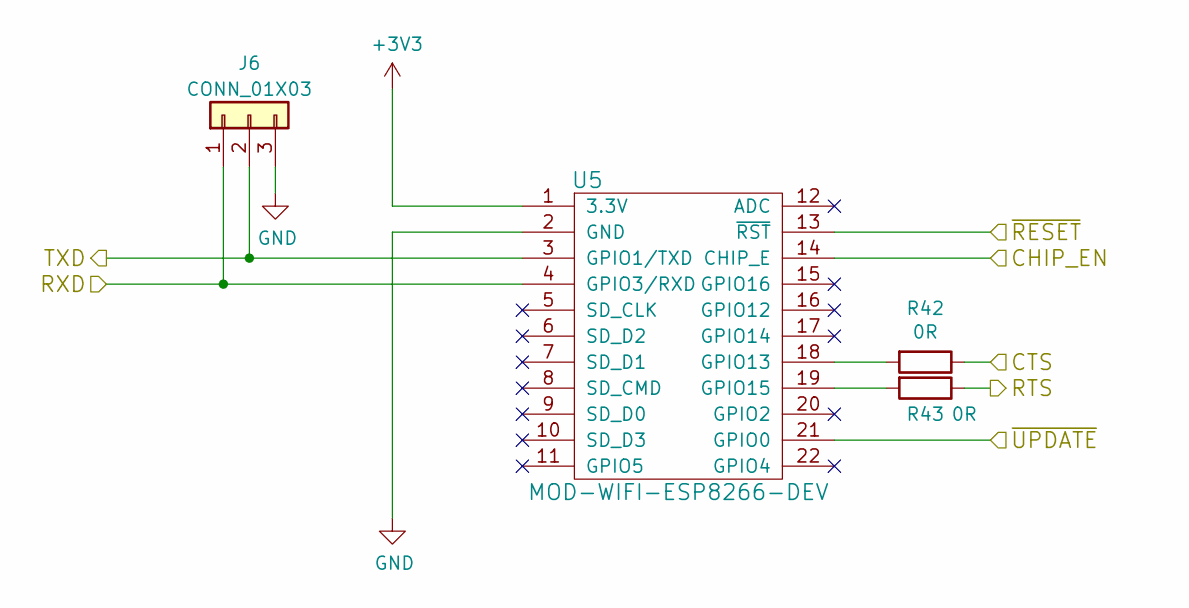
[picture p20: schematic Wireless.kicad_sch]

Parts:
J6: CONN_01X03; Pin_Header_Straight_1x03
R42, R43: 0R; R_0603_HandSoldering
U5: MOD-WIFI-ESP8266-DEV

Connections:
+3V3: U5.1 (3.3V)
CHIP_EN: U5.14 (CHIP_E)
CTS: R42.1
GND: J6.3, U5.2 (GND)
unnamed: R42.2, U5.18 (GPIO13)
unnamed: R43.2, U5.19 (GPIO15)
RTS: R43.1
RXD: J6.1, U5.4 (GPIO3/RXD)
TXD: J6.2, U5.3 (GPIO1/TXD)
~RESET: U5.13 (~RST)
~UPDATE: U5.21 (GPIO0)
