Marco-Peter/Morgenmuffel/src/userinput.c

/**************************************************************************/ /**
 * userinput.c
 *
 * Handling of user inputs (pushbuttons and turn knobs)
 * The user inputs are sampled each 50ms. If something happens an event will
 * be set.
 *
 * 2020 by M. Peter
 *
 *****************************************************************************/
#include <zephyr.h>
#include <device.h>
#include <devicetree.h>
#include <drivers/gpio.h>
#include "events.h"
#include "logging/log.h"
#include "stm32f2xx_ll_tim.h"

LOG_MODULE_REGISTER(userinput, LOG_LEVEL_ERR);

#define BTN_POWER_LABEL DT_GPIO_LABEL(DT_NODELABEL(btn_pwr), gpios)
#define BTN_POWER_PIN DT_GPIO_PIN(DT_NODELABEL(btn_pwr), gpios)
#define BTN_POWER_FLAGS DT_GPIO_FLAGS(DT_NODELABEL(btn_pwr), gpios)

#define BTN_SELECT_LABEL DT_GPIO_LABEL(DT_NODELABEL(btn_sel), gpios)
#define BTN_SELECT_PIN DT_GPIO_PIN(DT_NODELABEL(btn_sel), gpios)
#define BTN_SELECT_FLAGS DT_GPIO_FLAGS(DT_NODELABEL(btn_sel), gpios)

#define BTN_BACK_LABEL DT_GPIO_LABEL(DT_NODELABEL(btn_bk), gpios)
#define BTN_BACK_PIN DT_GPIO_PIN(DT_NODELABEL(btn_bk), gpios)
#define BTN_BACK_FLAGS DT_GPIO_FLAGS(DT_NODELABEL(btn_bk), gpios)

#define BTN_FORWARD_LABEL DT_GPIO_LABEL(DT_NODELABEL(btn_pwr), gpios)
#define BTN_FORWARD_PIN DT_GPIO_PIN(DT_NODELABEL(btn_fwd), gpios)
#define BTN_FORWARD_FLAGS DT_GPIO_FLAGS(DT_NODELABEL(btn_fwd), gpios)

#define BTN_MENU_LABEL DT_GPIO_LABEL(DT_NODELABEL(btn_menu), gpios)
#define BTN_MENU_PIN DT_GPIO_PIN(DT_NODELABEL(btn_menu), gpios)
#define BTN_MENU_FLAGS DT_GPIO_FLAGS(DT_NODELABEL(btn_menu), gpios)

#define BTN_PLAY_LABEL DT_GPIO_LABEL(DT_NODELABEL(btn_play), gpios)
#define BTN_PLAY_PIN DT_GPIO_PIN(DT_NODELABEL(btn_play), gpios)
#define BTN_PLAY_FLAGS DT_GPIO_FLAGS(DT_NODELABEL(btn_play), gpios)

#define BTN_ALARM1_LABEL DT_GPIO_LABEL(DT_NODELABEL(btn_alarm1), gpios)
#define BTN_ALARM1_PIN DT_GPIO_PIN(DT_NODELABEL(btn_alarm1), gpios)
#define BTN_ALARM1_FLAGS DT_GPIO_FLAGS(DT_NODELABEL(btn_alarm1), gpios)

#define BTN_ALARM2_LABEL DT_GPIO_LABEL(DT_NODELABEL(btn_alarm2), gpios)
#define BTN_ALARM2_PIN DT_GPIO_PIN(DT_NODELABEL(btn_alarm2), gpios)
#define BTN_ALARM2_FLAGS DT_GPIO_FLAGS(DT_NODELABEL(btn_alarm2), gpios)

#define BTN_ALARM3_LABEL DT_GPIO_LABEL(DT_NODELABEL(btn_alarm3), gpios)
#define BTN_ALARM3_PIN DT_GPIO_PIN(DT_NODELABEL(btn_alarm3), gpios)
#define BTN_ALARM3_FLAGS DT_GPIO_FLAGS(DT_NODELABEL(btn_alarm3), gpios)

#define ENC_SELECT_A_LABEL DT_GPIO_LABEL(DT_NODELABEL(enc_select_a), gpios)
#define ENC_SELECT_A_PIN DT_GPIO_PIN(DT_NODELABEL(enc_select_a), gpios)
#define ENC_SELECT_A_FLAGS DT_GPIO_FLAGS(DT_NODELABEL(enc_select_a), gpios)

#define ENC_SELECT_B_LABEL DT_GPIO_LABEL(DT_NODELABEL(enc_select_b), gpios)
#define ENC_SELECT_B_PIN DT_GPIO_PIN(DT_NODELABEL(enc_select_b), gpios)
#define ENC_SELECT_B_FLAGS DT_GPIO_FLAGS(DT_NODELABEL(enc_select_b), gpios)

#define ENC_VOLUME_A_LABEL DT_GPIO_LABEL(DT_NODELABEL(enc_volume_a), gpios)
#define ENC_VOLUME_A_PIN DT_GPIO_PIN(DT_NODELABEL(enc_volume_a), gpios)
#define ENC_VOLUME_A_FLAGS DT_GPIO_FLAGS(DT_NODELABEL(enc_volume_a), gpios)

#define ENC_VOLUME_B_LABEL DT_GPIO_LABEL(DT_NODELABEL(enc_volume_b), gpios)
#define ENC_VOLUME_B_PIN DT_GPIO_PIN(DT_NODELABEL(enc_volume_b), gpios)
#define ENC_VOLUME_B_FLAGS DT_GPIO_FLAGS(DT_NODELABEL(enc_volume_b), gpios)

#define BTN_POWER 0x00000001
#define BTN_SELECT 0x00000002
#define BTN_BACK 0x00000004
#define BTN_FORWARD 0x00000008
#define BTN_MENU 0x00000010
#define BTN_PLAY 0x00000020
#define BTN_ALARM1 0x00000040
#define BTN_ALARM2 0x00000080
#define BTN_ALARM3 0x00000100

#define ENC_VOLUME_A 0x00000001
#define ENC_VOLUME_B 0x00000002
#define ENC_SELECT_A 0x00000004
#define ENC_SELECT_B 0x00000008

#define CYCLE_PERIOD_MS 10
#define LONG_PUSH_TIME_MS 1000

#define BTN(_btn_) btn_##_btn_##_port, BTN_##_btn_##_PIN
#define BTN_CNF(_btn_)                                                         \
	BTN_##_btn_##_LABEL, BTN_##_btn_##_PIN, BTN_##_btn_##_FLAGS

struct encoder {
	const struct device *port_a;
	const struct device *port_b;
	struct gpio_callback callback_a;
	struct gpio_callback callback_b;
	const gpio_pin_t pin_a;
	const gpio_pin_t pin_b;
};

static const struct device *btn_POWER_port;
static const struct device *btn_SELECT_port;
static const struct device *btn_BACK_port;
static const struct device *btn_FORWARD_port;
static const struct device *btn_MENU_port;
static const struct device *btn_PLAY_port;
static const struct device *btn_ALARM1_port;
static const struct device *btn_ALARM2_port;
static const struct device *btn_ALARM3_port;

static struct encoder enc_select = {
	.pin_a = ENC_SELECT_A_PIN,
	.pin_b = ENC_SELECT_B_PIN
};
static struct encoder enc_volume = {
	.pin_a = ENC_VOLUME_A_PIN,
	.pin_b = ENC_VOLUME_B_PIN
};

static void encoder_cb_a(const struct device *port,
				struct gpio_callback *cb, gpio_port_pins_t pins)
{
	const struct encoder *encoder =
		CONTAINER_OF(cb, struct encoder, callback_a);
	int rc;
	int state_enc_a;
	int state_enc_b;

	rc = gpio_pin_interrupt_configure(encoder->port_a, encoder->pin_a,
					  GPIO_INT_DISABLE);
	if (rc != 0) {
		LOG_ERR("Failed to disable interrupt of %s.%d with status %d",
			encoder->port_a->name, encoder->pin_a, rc);
	}
	rc = gpio_pin_interrupt_configure(encoder->port_b, encoder->pin_b,
					  GPIO_INT_EDGE_BOTH);
	if (rc != 0) {
		LOG_ERR("Failed to enable interrupt of %s.%d with status %d",
			encoder->port_b->name, encoder->pin_b, rc);
	}
	state_enc_a = gpio_pin_get(encoder->port_a, encoder->pin_a);
	state_enc_b = gpio_pin_get(encoder->port_b, encoder->pin_b);
	if (state_enc_a != state_enc_b) {
		k_poll_signal_raise(&buttonEvents, EVT_ENC_SELECT_UP);
	} else {
		k_poll_signal_raise(&buttonEvents, EVT_ENC_SELECT_DN);
	}
}

static void encoder_cb_b(const struct device *port,
				struct gpio_callback *cb, gpio_port_pins_t pins)
{
	const struct encoder *encoder =
		CONTAINER_OF(cb, struct encoder, callback_b);
	int rc;

	rc = gpio_pin_interrupt_configure(encoder->port_b, encoder->pin_b,
					  GPIO_INT_DISABLE);
	if (rc != 0) {
		LOG_ERR("Failed to disable interrupt of %s.%d with status %d",
			encoder->port_b->name, encoder->pin_b, rc);
	}
	rc = gpio_pin_interrupt_configure(encoder->port_a, encoder->pin_a,
					  GPIO_INT_EDGE_BOTH);
	if (rc != 0) {
		LOG_ERR("Failed to enable interrupt of %s.%d with status %d",
			encoder->port_a->name, encoder->pin_a, rc);
	}
}

static const struct device *configure_port(const char *label, gpio_pin_t pin,
					   gpio_flags_t flags)
{
	const struct device *port;
	int rc;

	port = device_get_binding(label);
	if (port == NULL) {
		LOG_ERR("Failed to get binding of %s", label);
	}
	rc = gpio_pin_configure(port, pin, GPIO_INPUT | flags);
	if (rc != 0) {
		LOG_ERR("Failed to configure %s", label);
	}
	return port;
}

static void init_encoders(void)
{
	LL_TIM_InitTypeDef init = {
		.Prescaler = 0U,
		.CounterMode = LL_TIM_COUNTERMODE_UP,
		.Autoreload = 100,
		.ClockDivision = LL_TIM_CLOCKDIVISION_DIV1,
		.RepetitionCounter = 0
	};
	int rc;

	enc_volume.port_a = configure_port(ENC_VOLUME_A_LABEL, ENC_VOLUME_A_PIN,
					   ENC_VOLUME_A_FLAGS);
	enc_volume.port_b = configure_port(ENC_VOLUME_B_LABEL, ENC_VOLUME_B_PIN,
					   ENC_VOLUME_B_FLAGS);
	enc_select.port_a = configure_port(ENC_SELECT_A_LABEL, ENC_SELECT_A_PIN,
					   ENC_SELECT_A_FLAGS);
	enc_select.port_b = configure_port(ENC_SELECT_B_LABEL, ENC_SELECT_B_PIN,
					   ENC_SELECT_B_FLAGS);

	rc = gpio_pin_interrupt_configure(enc_volume.port_a, enc_volume.pin_a,
					  GPIO_INT_EDGE_BOTH);

	if (rc != 0) {
		LOG_ERR("Failed to configure interrupt of volume encoder A with rc %d",
			rc);
	}
	rc = gpio_pin_interrupt_configure(enc_select.port_a, enc_select.pin_a,
					  GPIO_INT_EDGE_BOTH);
	if (rc != 0) {
		LOG_ERR("Failed to configure interrupt of select encoder A with rc %d",
			rc);
	}
	gpio_init_callback(&enc_volume.callback_a, encoder_cb_a,
			   BIT(ENC_VOLUME_A_PIN));
	gpio_init_callback(&enc_volume.callback_b, encoder_cb_b,
			   BIT(ENC_VOLUME_B_PIN));
	gpio_init_callback(&enc_select.callback_a, encoder_cb_a,
			   BIT(ENC_SELECT_A_PIN));
	gpio_init_callback(&enc_select.callback_b, encoder_cb_b,
			   BIT(ENC_SELECT_B_PIN));
	rc = gpio_add_callback(enc_volume.port_a, &enc_volume.callback_a);
	if (rc != 0) {
		LOG_ERR("Failed to add interrupt callback to volume encoder with rc %d",
			rc);
	}
	rc = gpio_add_callback(enc_volume.port_b, &enc_volume.callback_b);
	if (rc != 0) {
		LOG_ERR("Failed to add interrupt callback to volume encoder with rc %d",
			rc);
	}
	rc = gpio_add_callback(enc_select.port_a, &enc_select.callback_a);
	if (rc != 0) {
		LOG_ERR("Failed to add interrupt callback to select encoder with rc %d",
			rc);
	}
	rc = gpio_add_callback(enc_select.port_b, &enc_select.callback_b);
	if (rc != 0) {
		LOG_ERR("Failed to add interrupt callback to select encoder with rc %d",
			rc);
	}
}

static void scan_buttons(void)
{
	static uint32_t newBtnStates;
	static uint32_t btnEvents;
	static uint32_t oldBtnStates;
	int pressStart = k_uptime_get_32();

	newBtnStates = 0;
	newBtnStates |= gpio_pin_get(BTN(POWER)) ? BTN_POWER : 0;
	newBtnStates |= gpio_pin_get(BTN(SELECT)) ? BTN_SELECT : 0;
	newBtnStates |= gpio_pin_get(BTN(BACK)) ? BTN_BACK : 0;
	newBtnStates |= gpio_pin_get(BTN(FORWARD)) ? BTN_FORWARD : 0;
	newBtnStates |= gpio_pin_get(BTN(MENU)) ? BTN_MENU : 0;
	newBtnStates |= gpio_pin_get(BTN(PLAY)) ? BTN_PLAY : 0;
	newBtnStates |= gpio_pin_get(BTN(ALARM1)) ? BTN_ALARM1 : 0;
	newBtnStates |= gpio_pin_get(BTN(ALARM2)) ? BTN_ALARM2 : 0;
	newBtnStates |= gpio_pin_get(BTN(ALARM3)) ? BTN_ALARM3 : 0;

	/* Find out if any buttons have been released before the timeout */
	btnEvents = (~newBtnStates & oldBtnStates);
	if (btnEvents & BTN_POWER) {
		k_poll_signal_raise(&buttonEvents, EVT_BTN_POWER_SHORT);
	}
	if (btnEvents & BTN_SELECT) {
		k_poll_signal_raise(&buttonEvents, EVT_BTN_SELECT_SHORT);
	}
	if (btnEvents & BTN_BACK) {
		k_poll_signal_raise(&buttonEvents, EVT_BTN_BACK_SHORT);
	}
	if (btnEvents & BTN_FORWARD) {
		k_poll_signal_raise(&buttonEvents, EVT_BTN_FWD_SHORT);
	}
	if (btnEvents & BTN_MENU) {
		k_poll_signal_raise(&buttonEvents, EVT_BTN_MENU_SHORT);
	}
	if (btnEvents & BTN_PLAY) {
		k_poll_signal_raise(&buttonEvents, EVT_BTN_PLAY_SHORT);
	}
	if (btnEvents & BTN_ALARM1) {
		k_poll_signal_raise(&buttonEvents, EVT_BTN_ALARM1_SHORT);
	}
	if (btnEvents & BTN_ALARM2) {
		k_poll_signal_raise(&buttonEvents, EVT_BTN_ALARM2_SHORT);
	}
	if (btnEvents & BTN_ALARM3) {
		k_poll_signal_raise(&buttonEvents, EVT_BTN_ALARM3_SHORT);
	}
	if (newBtnStates & ~oldBtnStates) {
		pressStart = k_uptime_get_32();
	}
	if ((newBtnStates & oldBtnStates) &&
	    (k_uptime_get_32() - pressStart > LONG_PUSH_TIME_MS)) {
		if (btnEvents & BTN_POWER) {
			k_poll_signal_raise(&buttonEvents, EVT_BTN_POWER_LONG);
		}
		if (btnEvents & BTN_SELECT) {
			k_poll_signal_raise(&buttonEvents, EVT_BTN_SELECT_LONG);
		}
		if (btnEvents & BTN_BACK) {
			k_poll_signal_raise(&buttonEvents, EVT_BTN_BACK_LONG);
		}
		if (btnEvents & BTN_FORWARD) {
			k_poll_signal_raise(&buttonEvents, EVT_BTN_FWD_LONG);
		}
		if (btnEvents & BTN_MENU) {
			k_poll_signal_raise(&buttonEvents, EVT_BTN_MENU_LONG);
		}
		if (btnEvents & BTN_PLAY) {
			k_poll_signal_raise(&buttonEvents, EVT_BTN_PLAY_LONG);
		}
		if (btnEvents & BTN_ALARM1) {
			k_poll_signal_raise(&buttonEvents, EVT_BTN_ALARM1_LONG);
		}
		if (btnEvents & BTN_ALARM2) {
			k_poll_signal_raise(&buttonEvents, EVT_BTN_ALARM2_LONG);
		}
		if (btnEvents & BTN_ALARM3) {
			k_poll_signal_raise(&buttonEvents, EVT_BTN_ALARM3_LONG);
		}
		newBtnStates = 0;
	}
	oldBtnStates = newBtnStates;
}

static void scan_inputs(void)
{
	btn_POWER_port = configure_port(BTN_CNF(POWER));
	btn_SELECT_port = configure_port(BTN_CNF(SELECT));
	btn_BACK_port = configure_port(BTN_CNF(BACK));
	btn_FORWARD_port = configure_port(BTN_CNF(FORWARD));
	btn_MENU_port = configure_port(BTN_CNF(MENU));
	btn_PLAY_port = configure_port(BTN_CNF(PLAY));
	btn_ALARM1_port = configure_port(BTN_CNF(ALARM1));
	btn_ALARM2_port = configure_port(BTN_CNF(ALARM2));
	btn_ALARM3_port = configure_port(BTN_CNF(ALARM3));

	init_encoders();

	while (true) {
		k_msleep(CYCLE_PERIOD_MS);
		scan_buttons();
	}
}

K_THREAD_DEFINE(userinput, 256, scan_inputs, NULL, NULL, NULL, 1, K_ESSENTIAL,
		1000);
