Marco-Peter/Morgenmuffel/src/free_sans_16.c

#include <lvgl.h>

/*******************************************************************************
 * Size: 16 px
 * Bpp: 1
 * Opts: 
 ******************************************************************************/

#ifndef FREE_SANS_16
#define FREE_SANS_16 1
#endif

#if FREE_SANS_16

/*-----------------
 *    BITMAPS
 *----------------*/

/*Store the image of the glyphs*/
static LV_ATTRIBUTE_LARGE_CONST const uint8_t gylph_bitmap[] = {
    /* U+20 " " */
    0x0,

    /* U+21 "!" */
    0xff, 0x90,

    /* U+22 "\"" */
    0x99, 0x99,

    /* U+23 "#" */
    0x13, 0x9, 0x4, 0x8f, 0xf1, 0x21, 0xb0, 0x91,
    0xfe, 0x24, 0x12, 0x9, 0xc, 0x80,

    /* U+24 "$" */
    0x10, 0x7c, 0xd6, 0x92, 0x90, 0xd0, 0x7c, 0x1e,
    0x11, 0x91, 0x91, 0xd2, 0x7c, 0x10, 0x10,

    /* U+25 "%" */
    0x70, 0x46, 0xc4, 0x22, 0x21, 0x12, 0xd, 0x90,
    0x39, 0x0, 0x9, 0xc0, 0x9b, 0x4, 0x88, 0x44,
    0x42, 0x36, 0x20, 0xe0,

    /* U+26 "&" */
    0x3c, 0x21, 0x10, 0x8c, 0xc7, 0xe1, 0xe1, 0xe1,
    0x9a, 0x8f, 0x43, 0x31, 0xcf, 0xb0,

    /* U+27 "'" */
    0xf0,

    /* U+28 "(" */
    0x29, 0x29, 0x24, 0x92, 0x44, 0x91,

    /* U+29 ")" */
    0x91, 0x22, 0x49, 0x24, 0x94, 0x94,

    /* U+2A "*" */
    0x25, 0x5c, 0xa5, 0x0,

    /* U+2B "+" */
    0x10, 0x10, 0x10, 0xff, 0x10, 0x10, 0x10, 0x10,

    /* U+2C "," */
    0xd7,

    /* U+2D "-" */
    0xf0,

    /* U+2E "." */
    0x80,

    /* U+2F "/" */
    0x10, 0x84, 0x42, 0x10, 0x88, 0x42, 0x21, 0x0,

    /* U+30 "0" */
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
    0x20, 0x10, 0x8, 0x0,

    /* U+21B "ț" */
    0x44, 0x4f, 0x44, 0x44, 0x44, 0x47, 0x4, 0x44,
    0x40,

    /* U+20AC "€" */
    0xf, 0x86, 0x23, 0x0, 0x80, 0xff, 0x18, 0xf,
    0xe0, 0x80, 0x20, 0xc, 0x1, 0x88, 0x3e
};


/*---------------------
 *  GLYPH DESCRIPTION
 *--------------------*/

static const lv_font_fmt_txt_glyph_dsc_t glyph_dsc[] = {
    {.bitmap_index = 0, .adv_w = 0, .box_w = 0, .box_h = 0, .ofs_x = 0, .ofs_y = 0} /* id = 0 reserved */,
    {.bitmap_index = 0, .adv_w = 64, .box_w = 1, .box_h = 1, .ofs_x = 0, .ofs_y = 0},
    {.bitmap_index = 1, .adv_w = 85, .box_w = 1, .box_h = 12, .ofs_x = 2, .ofs_y = 0},
    {.bitmap_index = 3, .adv_w = 85, .box_w = 4, .box_h = 4, .ofs_x = 1, .ofs_y = 8},
    {.bitmap_index = 5, .adv_w = 142, .box_w = 9, .box_h = 12, .ofs_x = 1, .ofs_y = 0},
    {.bitmap_index = 19, .adv_w = 142, .box_w = 8, .box_h = 15, .ofs_x = 1, .ofs_y = -2},
    {.bitmap_index = 34, .adv_w = 228, .box_w = 13, .box_h = 12, .ofs_x = 1, .ofs_y = 0},
    {.bitmap_index = 54, .adv_w = 171, .box_w = 9, .box_h = 12, .ofs_x = 1, .ofs_y = 0},
    {.bitmap_index = 68, .adv_w = 51, .box_w = 1, .box_h = 4, .ofs_x = 1, .ofs_y = 8},
    {.bitmap_index = 69, .adv_w = 85, .box_w = 3, .box_h = 16, .ofs_x = 1, .ofs_y = -4},
    {.bitmap_index = 75, .adv_w = 85, .box_w = 3, .box_h = 16, .ofs_x = 1, .ofs_y = -4},
    {.bitmap_index = 81, .adv_w = 100, .box_w = 5, .box_h = 5, .ofs_x = 1, .ofs_y = 7},
    {.bitmap_index = 85, .adv_w = 150, .box_w = 8, .box_h = 8, .ofs_x = 1, .ofs_y = 0},
    {.bitmap_index = 93, .adv_w = 71, .box_w = 2, .box_h = 4, .ofs_x = 1, .ofs_y = -3},
    {.bitmap_index = 94, .adv_w = 85, .box_w = 4, .box_h = 1, .ofs_x = 1, .ofs_y = 4},
    {.bitmap_index = 95, .adv_w = 64, .box_w = 1, .box_h = 1, .ofs_x = 1, .ofs_y = 0},
    {.bitmap_index = 96, .adv_w = 71, .box_w = 5, .box_h = 12, .ofs_x = 0, .ofs_y = 0},
    {.bitmap_index = 104, .adv_w = 142, .box_w = 7, .box_h = 12, .ofs_x = 1, .ofs_y = 0},
    {.bitmap_index = 115, .adv_w = 142, .box_w = 4, .box_h = 12, .ofs_x = 1, .ofs_y = 0},
    {.bitmap_index = 121, .adv_w = 142, .box_w = 7, .box_h = 12, .ofs_x = 1, .ofs_y = 0},
    {.bitmap_index = 132, .adv_w = 142, .box_w = 7, .box_h = 12, .ofs_x = 1, .ofs_y = 0},
    {.bitmap_index = 143, .adv_w = 142, .box_w = 8, .box_h = 12, .ofs_x = 1, .ofs_y = 0},
    {.bitmap_index = 155, .adv_w = 142, .box_w = 7, .box_h = 12, .ofs_x = 1, .ofs_y = 0},
    {.bitmap_index = 166, .adv_w = 142, .box_w = 7, .box_h = 12, .ofs_x = 1, .ofs_y = 0},
    {.bitmap_index = 177, .adv_w = 142, .box_w = 8, .box_h = 12, .ofs_x = 1, .ofs_y = 0},
    {.bitmap_index = 189, .adv_w = 142, .box_w = 7, .box_h = 12, .ofs_x = 1, .ofs_y = 0},
    {.bitmap_index = 200, .adv_w = 142, .box_w = 7, .box_h = 12, .ofs_x = 1, .ofs_y = 0},
    {.bitmap_index = 211, .adv_w = 64, .box_w = 1, .box_h = 9, .ofs_x = 1, .ofs_y = 0},
    {.bitmap_index = 213, .adv_w = 64, .box_w = 2, .box_h = 12, .ofs_x = 1, .ofs_y = -3},
    {.bitmap_index = 216, .adv_w = 150, .box_w = 8, .box_h = 8, .ofs_x = 1, .ofs_y = 0},
    {.bitmap_index = 224, .adv_w = 150, .box_w = 8, .box_h = 4, .ofs_x = 1, .ofs_y = 2},
    {.bitmap_index = 228, .adv_w = 150, .box_w = 8, .box_h = 8, .ofs_x = 1, .ofs_y = 0},
    {.bitmap_index = 236, .adv_w = 142, .box_w = 7, .box_h = 12, .ofs_x = 1, .ofs_y = 0},
    {.bitmap_index = 247, .adv_w = 260, .box_w = 14, .box_h = 14, .ofs_x = 1, .ofs_y = -2},
    {.bitmap_index = 272, .adv_w = 170, .box_w = 10, .box_h = 12, .ofs_x = 0, .ofs_y = 0},
    {.bitmap_index = 287, .adv_w = 170, .box_w = 8, .box_h = 12, .ofs_x = 1, .ofs_y = 0},
    {.bitmap_index = 299, .adv_w = 182, .box_w = 10, .box_h = 12, .ofs_x = 1, .ofs_y = 0},
    {.bitmap_index = 314, .adv_w = 179, .box_w = 9, .box_h = 12, .ofs_x = 1, .ofs_y = 0},
    {.bitmap_index = 328, .adv_w = 162, .box_w = 8, .box_h = 12, .ofs_x = 1, .ofs_y = 0},
    {.bitmap_index = 340, .adv_w = 153, .box_w = 7, .box_h = 12, .ofs_x = 1, .ofs_y = 0},
    {.bitmap_index = 351, .adv_w = 196, .box_w = 10, .box_h = 12, .ofs_x = 1, .ofs_y = 0},
    {.bitmap_index = 366, .adv_w = 185, .box_w = 9, .box_h = 12, .ofs_x = 1, .ofs_y = 0},
    {.bitmap_index = 380, .adv_w = 71, .box_w = 1, .box_h = 12, .ofs_x = 2, .ofs_y = 0},
    {.bitmap_index = 382, .adv_w = 135, .box_w = 6, .box_h = 12, .ofs_x = 1, .ofs_y = 0},
    {.bitmap_index = 391, .adv_w = 173, .box_w = 9, .box_h = 12, .ofs_x = 1, .ofs_y = 0},
    {.bitmap_index = 405, .adv_w = 144, .box_w = 7, .box_h = 12, .ofs_x = 1, .ofs_y = 0},
    {.bitmap_index = 416, .adv_w = 217, .box_w = 11, .box_h = 12, .ofs_x = 1, .ofs_y = 0},
    {.bitmap_index = 433, .adv_w = 187, .box_w = 9, .box_h = 12, .ofs_x = 1, .ofs_y = 0},
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
};

/*---------------------
 *  CHARACTER MAPPING
 *--------------------*/

static const uint8_t glyph_id_ofs_list_1[] = {
    0, 0, 1
};

static const uint16_t unicode_list_3[] = {
    0x0, 0x2, 0x8, 0xa, 0xf, 0x1a
};

static const uint8_t glyph_id_ofs_list_7[] = {
    0, 1, 2, 3, 4, 5, 0, 6,
    7, 8, 0, 0, 9, 10, 11, 12,
    13, 14, 0, 0, 15, 16, 17, 18,
    19, 20, 0, 0, 21, 22, 0, 0,
    23, 24, 0, 0, 25, 26, 27, 28,
    0, 0, 0, 0, 29, 30, 0, 31,
    32, 33, 34, 35, 36, 37, 38, 39,
    40, 41, 42, 43, 44, 45, 46, 0,
    47, 48, 0, 0, 0, 0, 49, 50,
    51, 52, 53, 54, 0, 0, 55, 56,
    57, 58, 0, 0, 59, 60, 61, 62,
    0, 0, 63, 64, 0, 0, 0, 0,
    65, 66, 0, 0, 67, 68, 69, 70,
    71, 72, 0, 73, 0, 74, 75, 76,
    77, 78, 79, 80, 81
};

static const uint16_t unicode_list_8[] = {
    0x0, 0x1, 0x2, 0x3, 0x1e94
};

/*Collect the unicode lists and glyph_id offsets*/
static const lv_font_fmt_txt_cmap_t cmaps[] =
{
    {
        .range_start = 32, .range_length = 60, .glyph_id_start = 1,
        .unicode_list = NULL, .glyph_id_ofs_list = NULL, .list_length = 0, .type = LV_FONT_FMT_TXT_CMAP_FORMAT0_TINY
    },
    {
        .range_start = 93, .range_length = 3, .glyph_id_start = 61,
        .unicode_list = NULL, .glyph_id_ofs_list = glyph_id_ofs_list_1, .list_length = 3, .type = LV_FONT_FMT_TXT_CMAP_FORMAT0_FULL
    },
    {
        .range_start = 97, .range_length = 26, .glyph_id_start = 63,
        .unicode_list = NULL, .glyph_id_ofs_list = NULL, .list_length = 0, .type = LV_FONT_FMT_TXT_CMAP_FORMAT0_TINY
    },
    {
        .range_start = 161, .range_length = 27, .glyph_id_start = 89,
        .unicode_list = unicode_list_3, .glyph_id_ofs_list = NULL, .list_length = 6, .type = LV_FONT_FMT_TXT_CMAP_SPARSE_TINY
    },
    {
        .range_start = 191, .range_length = 24, .glyph_id_start = 95,
        .unicode_list = NULL, .glyph_id_ofs_list = NULL, .list_length = 0, .type = LV_FONT_FMT_TXT_CMAP_FORMAT0_TINY
    },
    {
        .range_start = 216, .range_length = 31, .glyph_id_start = 119,
        .unicode_list = NULL, .glyph_id_ofs_list = NULL, .list_length = 0, .type = LV_FONT_FMT_TXT_CMAP_FORMAT0_TINY
    },
    {
        .range_start = 248, .range_length = 16, .glyph_id_start = 150,
        .unicode_list = NULL, .glyph_id_ofs_list = NULL, .list_length = 0, .type = LV_FONT_FMT_TXT_CMAP_FORMAT0_TINY
    },
    {
        .range_start = 266, .range_length = 117, .glyph_id_start = 166,
        .unicode_list = NULL, .glyph_id_ofs_list = glyph_id_ofs_list_7, .list_length = 117, .type = LV_FONT_FMT_TXT_CMAP_FORMAT0_FULL
    },
    {
        .range_start = 536, .range_length = 7829, .glyph_id_start = 248,
        .unicode_list = unicode_list_8, .glyph_id_ofs_list = NULL, .list_length = 5, .type = LV_FONT_FMT_TXT_CMAP_SPARSE_TINY
    }
};



/*--------------------
 *  ALL CUSTOM DATA
 *--------------------*/

/*Store all the custom data of the font*/
static lv_font_fmt_txt_dsc_t font_dsc = {
    .glyph_bitmap = gylph_bitmap,
    .glyph_dsc = glyph_dsc,
    .cmaps = cmaps,
    .kern_dsc = NULL,
    .kern_scale = 0,
    .cmap_num = 9,
    .bpp = 1,
    .kern_classes = 0,
    .bitmap_format = 0
};


/*-----------------
 *  PUBLIC FONT
 *----------------*/

/*Initialize a public general font descriptor*/
lv_font_t free_sans_16 = {
    .get_glyph_dsc = lv_font_get_glyph_dsc_fmt_txt,    /*Function pointer to get glyph's data*/
    .get_glyph_bitmap = lv_font_get_bitmap_fmt_txt,    /*Function pointer to get glyph's bitmap*/
    .line_height = 21,          /*The maximum line height required by the font*/
    .base_line = 5,             /*Baseline measured from the bottom of the line*/
#if !(LVGL_VERSION_MAJOR == 6 && LVGL_VERSION_MINOR == 0)
    .subpx = LV_FONT_SUBPX_NONE,
#endif
#if LV_VERSION_CHECK(7, 4, 0)
    .underline_position = -3,
    .underline_thickness = 1,
#endif
    .dsc = &font_dsc           /*The custom font data. Will be accessed by `get_glyph_bitmap/dsc` */
};



#endif /*#if FREE_SANS_16*/
