Marco-Peter/Morgenmuffel/drivers/si468x/zephyr/si46xx_rom00_mini_patch.h

/***************************************************************************************
                  Silicon Laboratories Broadcast Digital Radio SDK

   EVALUATION AND USE OF THIS SOFTWARE IS SUBJECT TO THE TERMS AND CONDITIONS OF
     THE SOFTWARE LICENSE AGREEMENT IN THE DOCUMENTATION FILE CORRESPONDING
     TO THIS SOURCE FILE.
   IF YOU DO NOT AGREE TO THE LIMITED LICENSE AND CONDITIONS OF SUCH AGREEMENT,
     PLEASE RETURN ALL SOURCE FILES TO SILICON LABORATORIES.

   si46xx bootloader mini patch to enable access to NVSPI connected flash
   FILE: si46xx_rom00_mini_patch.h
   Supported IC : Si468x
   Date: June 20 2014
  (C) Copyright 2014, Silicon Laboratories, Inc. All rights reserved.
****************************************************************************************/

#ifndef __MINIPATCH__
#define __MINIPATCH__

#include <stdint.h>

#define MINIPATCH_LENGTH 940

//This,is,the,minipatch_003.bin
//Declaring,in,code,space,to,save,RAM,and,to,ensure,we,dont,hit,a,watchdog,timeout,during,variable,init,(prior,to,entering,main())
const uint8_t minipatch[MINIPATCH_LENGTH]={
0x03,0x00,0x00,0xFE,0x00,0x00,0x00,0x00,0x00,0x00,0x00,0x00,0x78,0x56,0x34,0x12,
0x00,0x00,0x00,0x00,0x00,0x00,0x00,0x00,0x2C,0x5F,0xBE,0x2F,0x01,0x00,0x00,0x00,
0xEF,0xBE,0xAD,0xDE,0x50,0x03,0x00,0x00,0x03,0x00,0x00,0x00,0x04,0x00,0x00,0x00,
0x00,0x00,0x00,0x00,0x00,0x3C,0x20,0x50,0x01,0x00,0x00,0x00,0x6A,0x21,0xD6,0x4F,
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
0xFB,0x22,0xBB,0x1A,0xBE,0x53,0xC5,0xCE,0x9B,0x9C,0x04,0x2E,0xE5,0x45,0x72,0x8A,
0x80,0x87,0x8A,0xFE,0xF6,0x52,0xC2,0x6E,0x4E,0x0E,0x62,0x8B,0x86,0xFC,0x9F,0x23,
0x11,0x44,0x19,0xDF,0x8A,0xDF,0x4A,0x01,0x17,0xA8,0x37,0xAB,0xA3,0x7B,0xA4,0x0D,
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

#endif
