Marco-Peter/Morgenmuffel/src/powersupply.h

#ifndef POWERSUPPLY_H_
#define POWERSUPPLY_H_

int powersupply_request_5v(void);
int powersupply_release_5v(void);
int powersupply_request_1v8(void);
int powersupply_release_1v8(void);

#endif /* POWERSUPPLY_H_ */
