Marco-Peter/Morgenmuffel/src/parameters.h

/*
 * Copyright (c) 2019 Marco Peter
 *
 * This file contains all available parameter identifiers on the system.
 * Usage of the parameters are the task of the implementing modules.
 */

#pragma once

#include <zephyr/types.h>

#define PARAMETERS_BASE_PLAYLIST 1000

typedef struct parameters_t {
	uint16_t currentPlaylistItem;
	uint8_t volume;
} parameters_t;

extern parameters_t parameters;
