Marco-Peter/Morgenmuffel/(commit log)

2019-12-01 Board Dateien zu Projekt hinzugefügt
2019-12-06 Enabled SPI and I2C ports.
2019-12-08 Added SPI flash memory
2019-12-08 Added SPI Flash support to standard configuration
2019-12-11 Trying to get SPI flash working with nvs
2019-12-11 Trying to get communication with SPI interface alone, since flash initialisation fails during read of identifier.
    [main.c]
2019-12-19 Started with display driver port for Zephyr
2019-12-26 Added power control
2020-01-03 Updated project settings to work with current zephyr version
2020-01-03 Updated board settings to contain SPI NOR properties
2020-01-04 Raising display thread priority, so that it starts before the main thread.
2020-01-04 Using parameters as struct to be inserted into a file
2020-01-04 Currently disabling display usage during debug
2020-05-16 Removed obsolete UART configurations. Modified falsh area identification
2020-05-19 Updated and corrected GPIO definitions in device tree. Added encoder pins.
2020-06-13 Updated formatting and device tree
2020-06-13 Adding display to device tree
2020-06-13 Adding display support to project. Correcting some elements in device tree.
2020-06-14 Added data_cmd pin to device tree configuration
2020-07-12 Adding VS1053 driver including test.
2020-10-10 Removed old display driver.
2020-10-11 Updated device structs to be const.
2020-10-12 Added power supply rails
2020-10-13 Made power supply module self initialising.
2020-10-14 Corrected display settings on device tree
2020-10-14 Replaced fifo with a message queue, added generic display clear function. Increased thread stack.
    [display.c, display.h]
2020-10-14 Updated board to support any sample
2020-10-14 Reverted renaming of display off function
    [display.c, display.h, main.c]
2020-10-15 Adding SHT2x driver
2020-10-15 Added driver for SHT21 sensor
2020-10-15 Added function to measure temperature
2020-10-15 Corrected return type of measurement functions. Added measurement function to main.
    [main.c, sht2x.c]
2020-10-15 Completed SHT21 driver and test application
2020-10-16 Started with pressure sensor
2020-10-16 Using sensor interface for SHT21 driver
2020-10-16 corrected return data types
    [sht2x.c]
2020-10-16 Driver initialises (and CRC works finally...)
2020-10-18 Driver compiles, but does nothing yet.
2020-10-19 Removed floating point operations from driver
2020-10-20 Removed work queue.
    This should not be managed by driver (unless configurable)
2020-10-20 Some driver adaptions
2020-10-20 Added SI4689 and VS1053 to device tree
2020-10-20 Working on SI4689 driver
2020-10-22 Adding request for 1.8V on application start
2020-10-22 si468x is properly booting into FM and DAB firmware. Simplified power supply control.
2020-10-24 Added description of interrupt flow
2020-10-26 give semaphor when interrupts still are pending
2020-10-29 Added pin configuration for USB FS (device interface)
2020-10-29 Correction of pin description
2020-10-30 Implemented uart forwarding
2020-10-30 Corrected a few things
    [main.c]
2020-11-01 Moved pinmux configuration of uarts, spis and i2cs to device tree.
2020-11-03 Further work on usb device handling
2020-11-07 Moved usb pinmux configuration to device tree.
2020-11-07 Moved Ethernet pinmux configuration to device tree. Only remaining pin is MCO2.
2020-11-22 Button sampling works, but is too slow for proper detection of encoder direction.
    [events.c, main.c, userinput.c]
2020-11-22 Not requiring negative logic on encoders. Adding interrupt configuration on encoder channels.
2020-11-22 Adding encoder callback functions.
2020-12-17 Changing to timer implementation for encoders.
2021-11-06 Update code to build with current Zephyr main
2022-03-19 Add cleaned up schematic in KiCad version 6 format.
    [Amplifier.kicad_sch, AudioOut.kicad_sch, BlueTooth.kicad_sch, Button.kicad_sch, CPU.kicad_sch, Crossover.kicad_sch, DECT.kicad_sch, Display.kicad_sch]
